HirthikBalaji/ShockGuard-CAD/Hardware/KiCad/index.html

## Redirecting to GitHub repository...

Click here if you are not redirected automatically (https://github.com/HirthikBalaji/ShockGuard-CAD/tree/main/Hardware/KiCad)
