HirthikBalaji/ShockGuard-CAD/Drawings/sheet_previews/Sheet_1.png

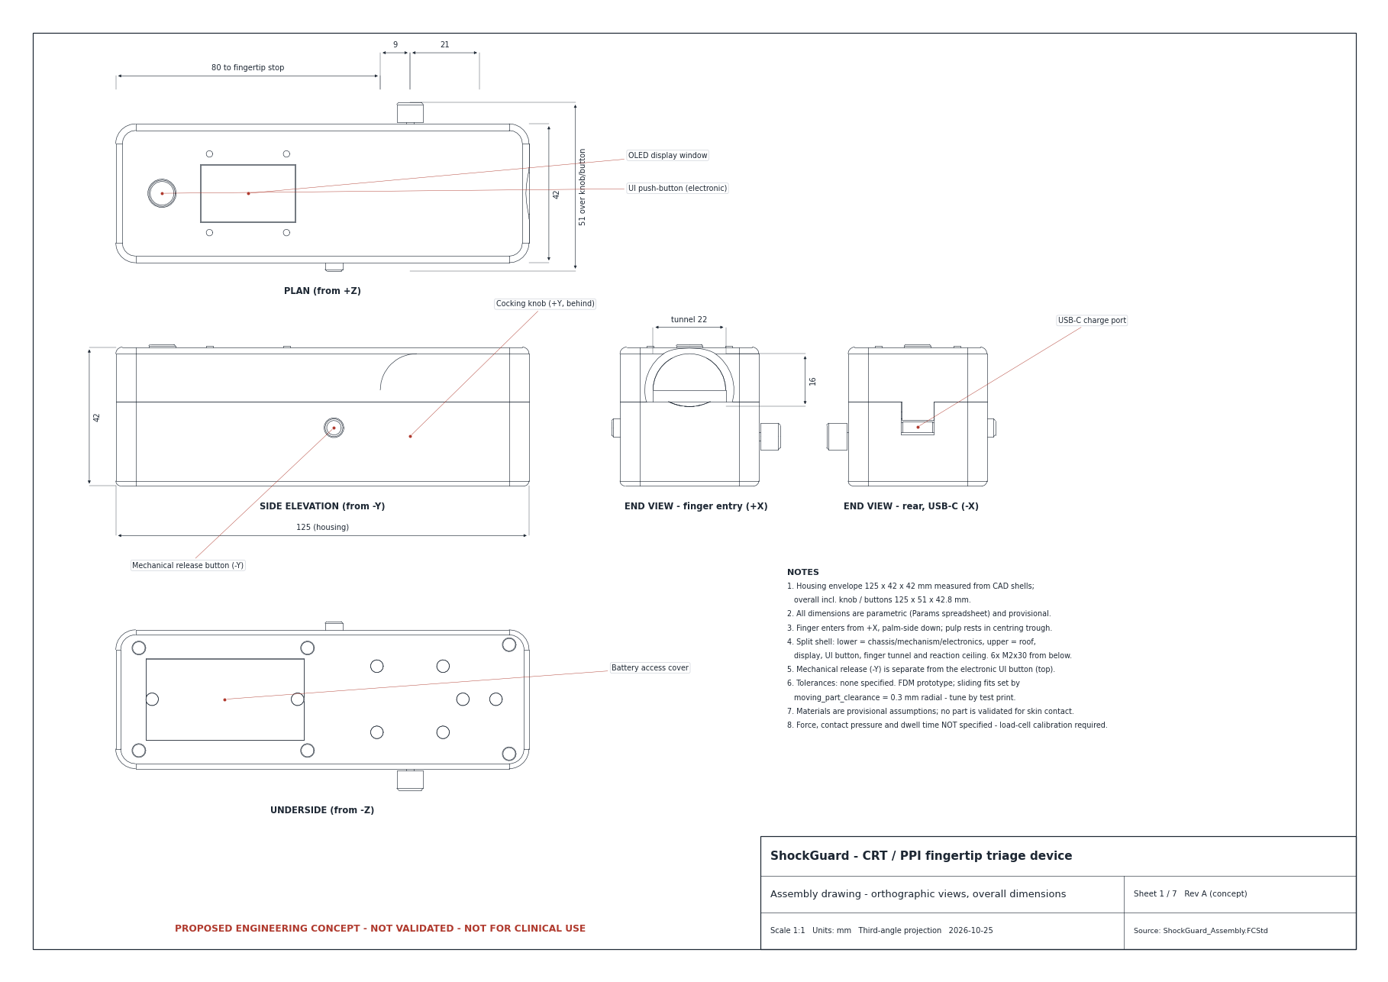
Drawings/sheet_previews/Sheet_1.png
