HirthikBalaji/ShockGuard-CAD/Drawings/sheet_previews/Sheet_2.png

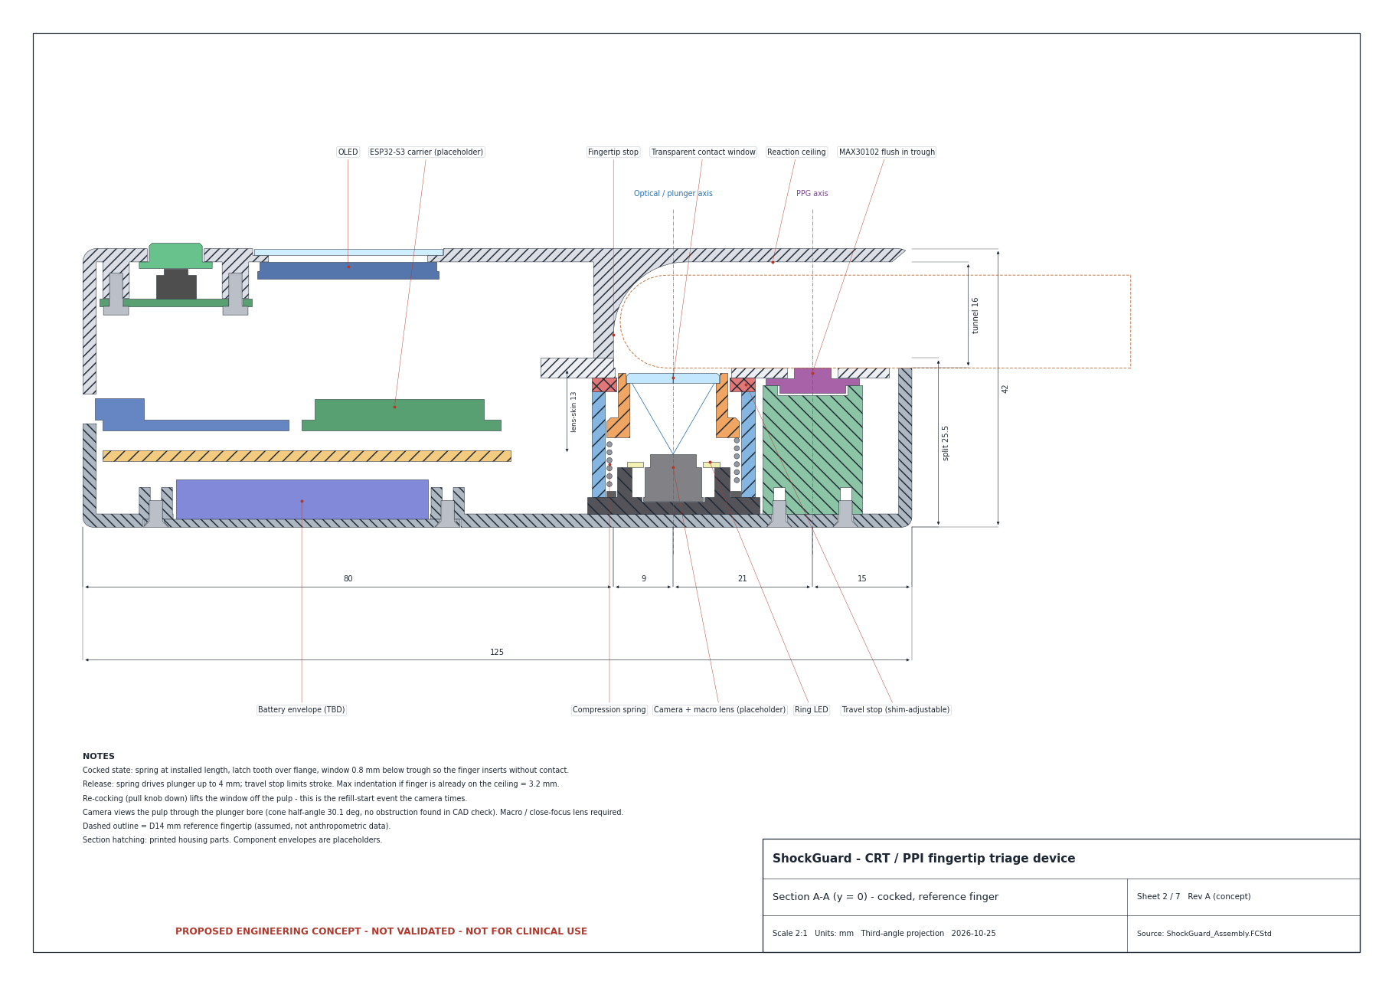
Drawings/sheet_previews/Sheet_2.png
