HirthikBalaji/ShockGuard-CAD/Drawings/sheet_previews/Sheet_3.png

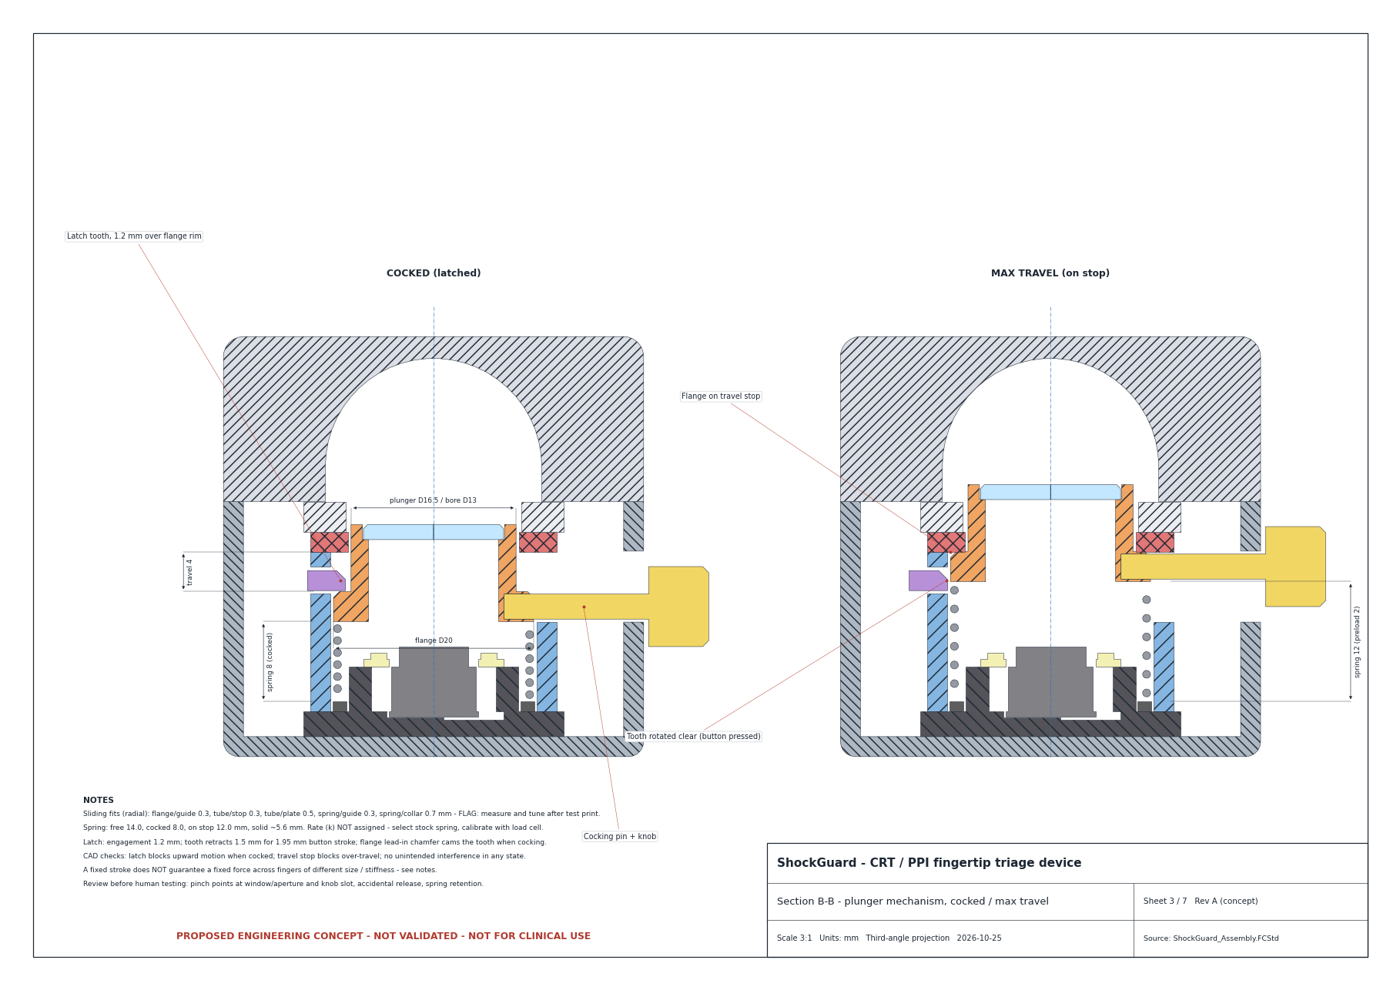
Drawings/sheet_previews/Sheet_3.png
