HirthikBalaji/ShockGuard-CAD/Drawings/sheet_previews/Sheet_4.png

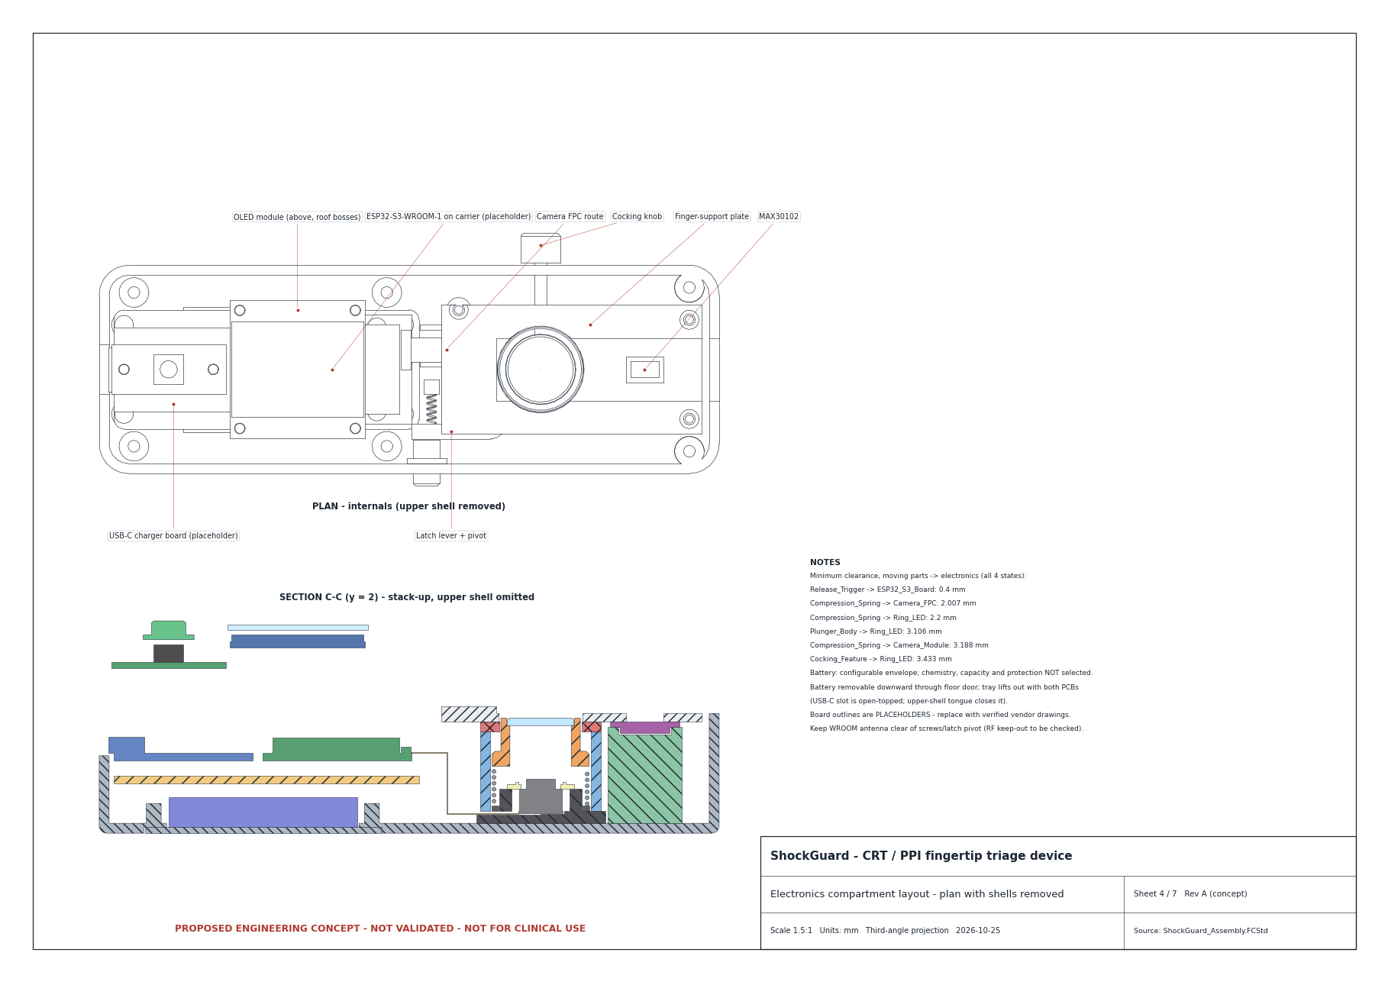
Drawings/sheet_previews/Sheet_4.png
