HirthikBalaji/ShockGuard-CAD/Drawings/sheet_previews/Sheet_5.png

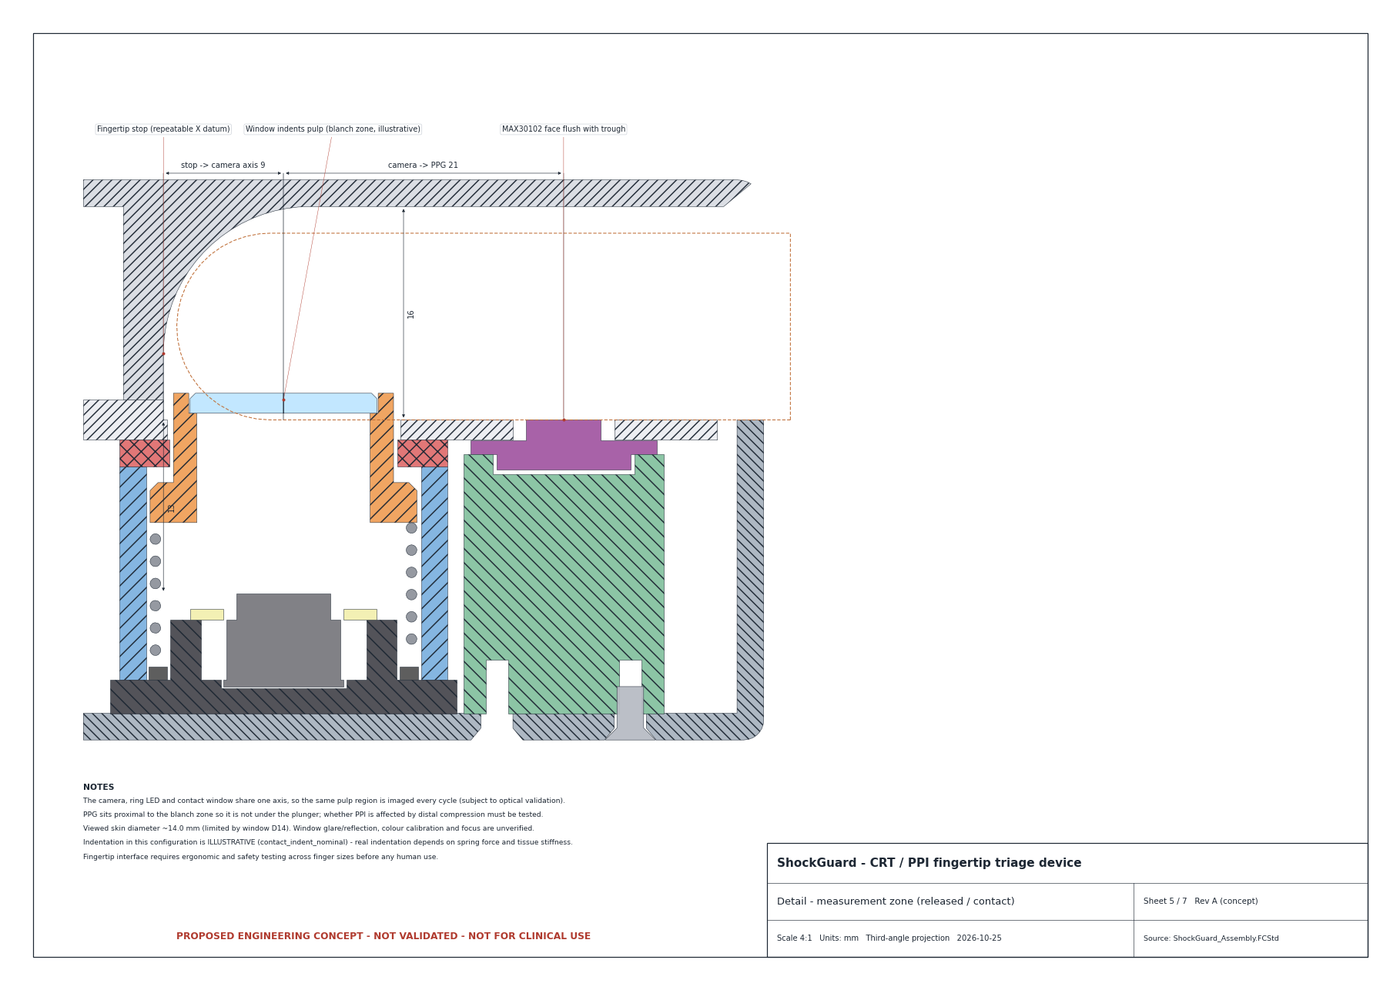
Drawings/sheet_previews/Sheet_5.png
