HirthikBalaji/ShockGuard-CAD/Drawings/sheet_previews/Sheet_6.png

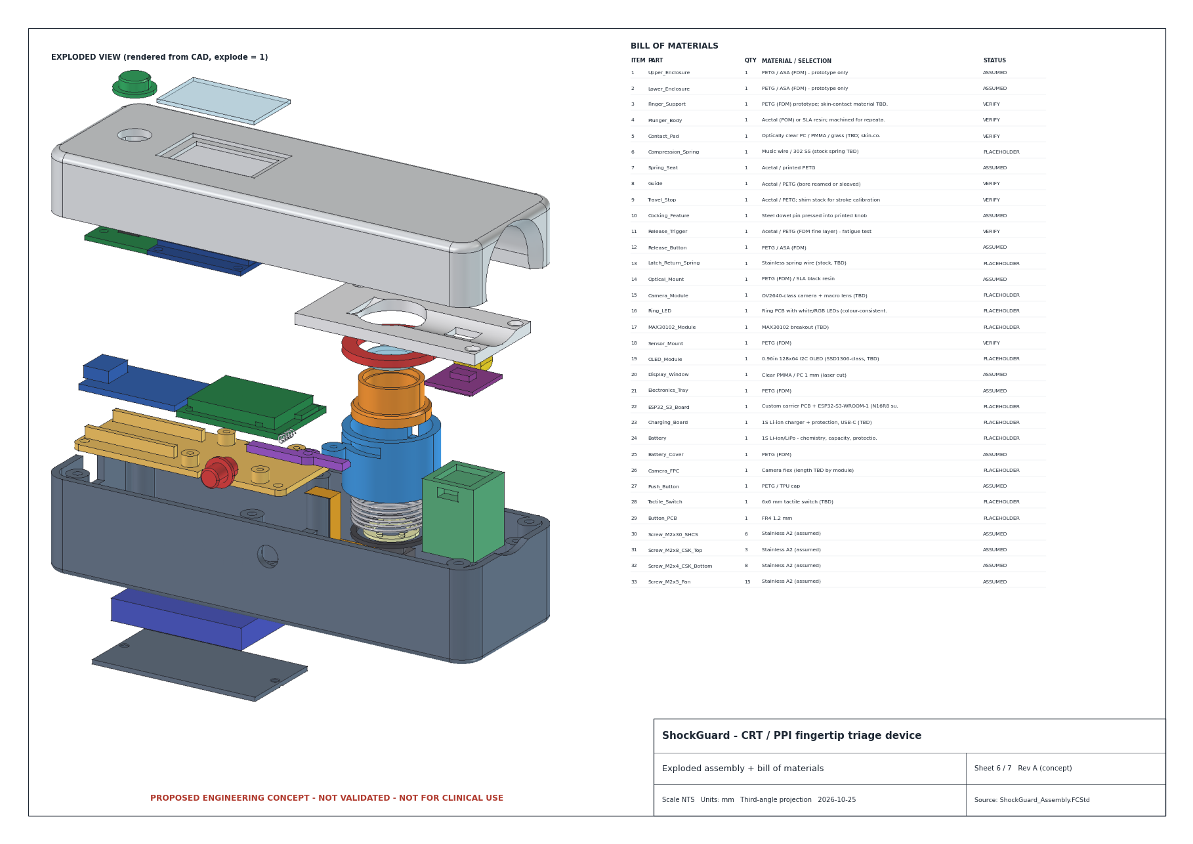
Drawings/sheet_previews/Sheet_6.png
