HirthikBalaji/ShockGuard-CAD/Drawings/sheet_previews/Sheet_7.png

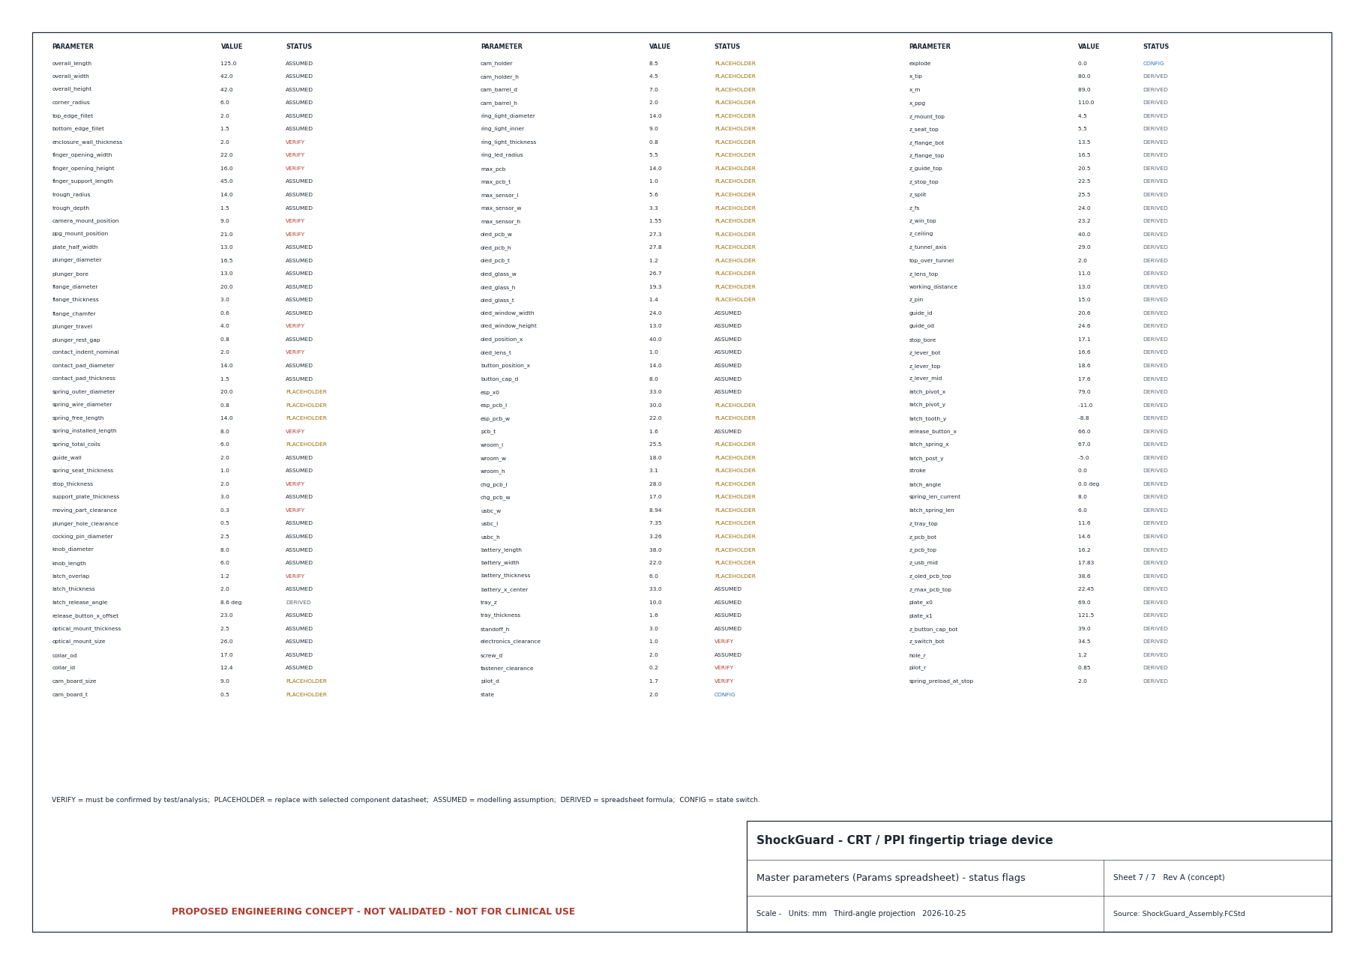
Drawings/sheet_previews/Sheet_7.png
