HirthikBalaji/ShockGuard-CAD/Renders/_raw/electronics.png

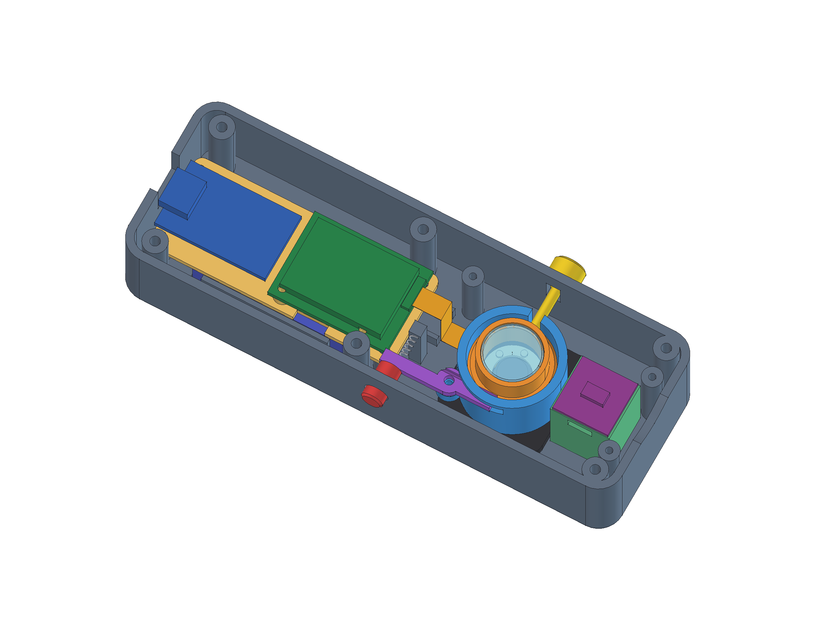
Renders/_raw/electronics.png
