HirthikBalaji/ShockGuard-CAD/Renders/_raw/electronics_display.png

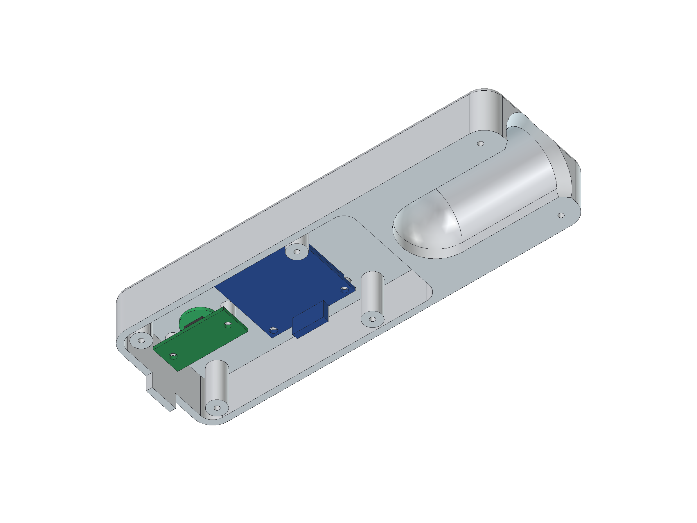
Renders/_raw/electronics_display.png
