HirthikBalaji/ShockGuard-CAD/Renders/_raw/exploded.png

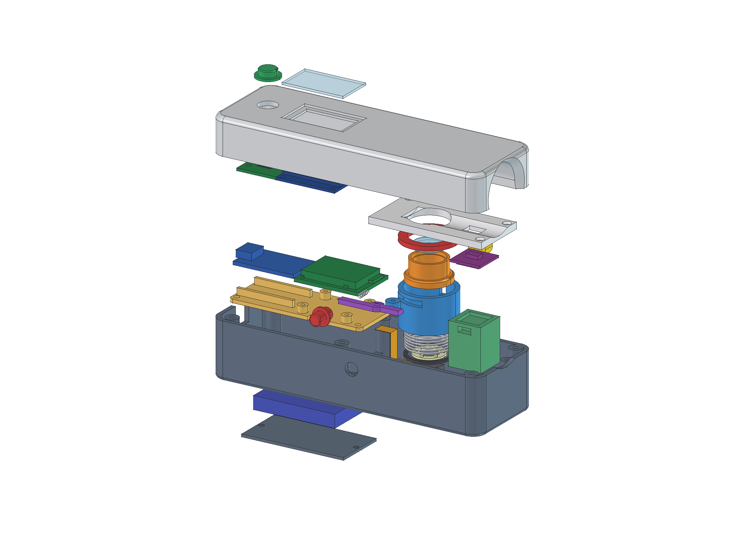
Renders/_raw/exploded.png
