HirthikBalaji/ShockGuard-CAD/Renders/_raw/iso.png

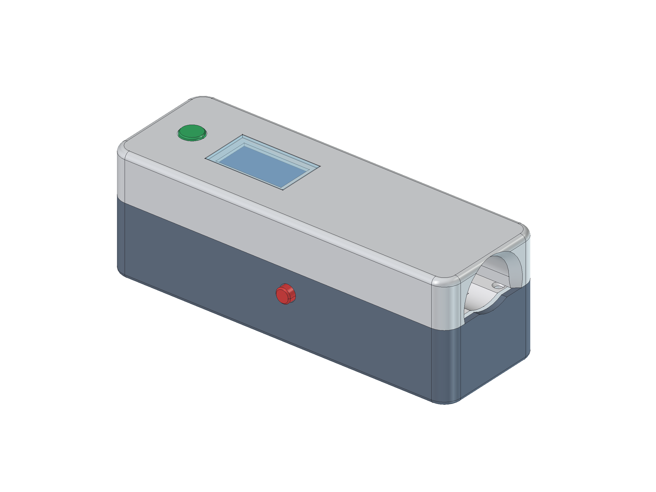
Renders/_raw/iso.png
