HirthikBalaji/ShockGuard-CAD/Renders/_raw/iso_bottom.png

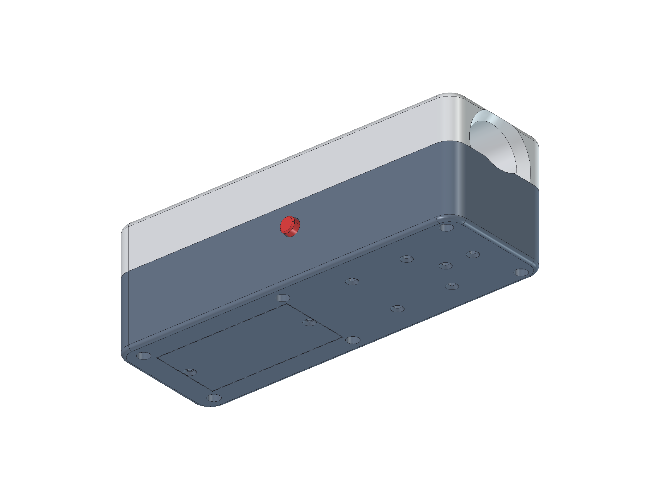
Renders/_raw/iso_bottom.png
