HirthikBalaji/ShockGuard-CAD/Renders/_raw/iso_finger.png

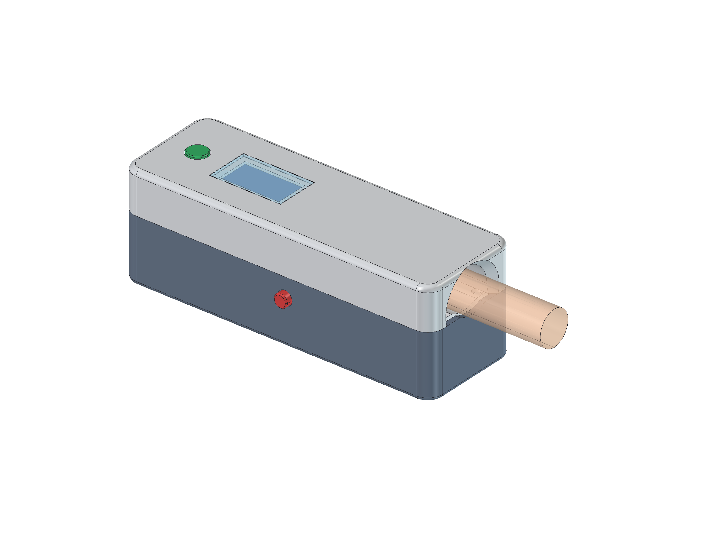
Renders/_raw/iso_finger.png
