HirthikBalaji/ShockGuard-CAD/Renders/_raw/iso_rear.png

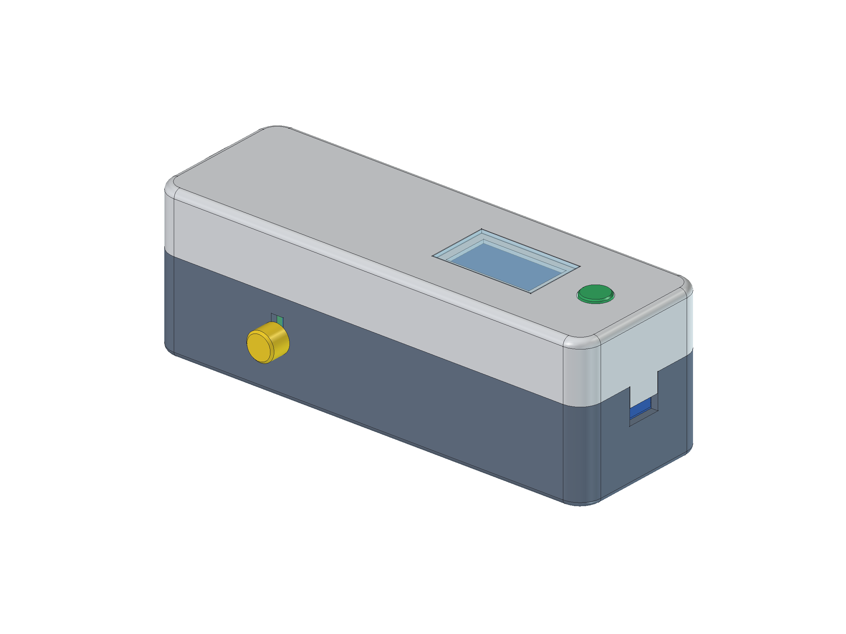
Renders/_raw/iso_rear.png
