HirthikBalaji/ShockGuard-CAD/Renders/_raw/mech_state_1.png

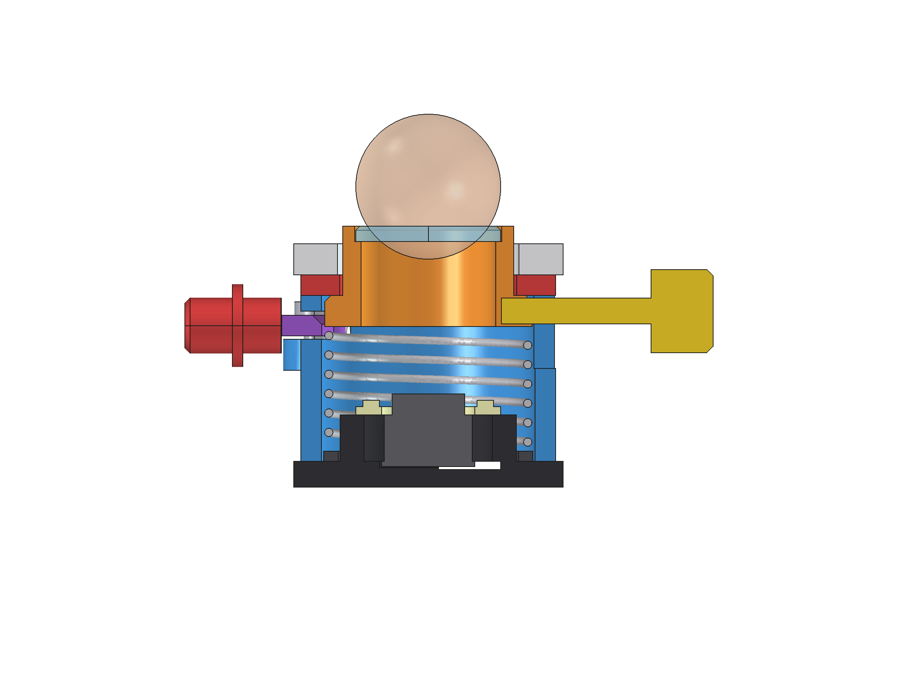
Renders/_raw/mech_state_1.png
