HirthikBalaji/ShockGuard-CAD/Renders/_raw/ortho_bottom.png

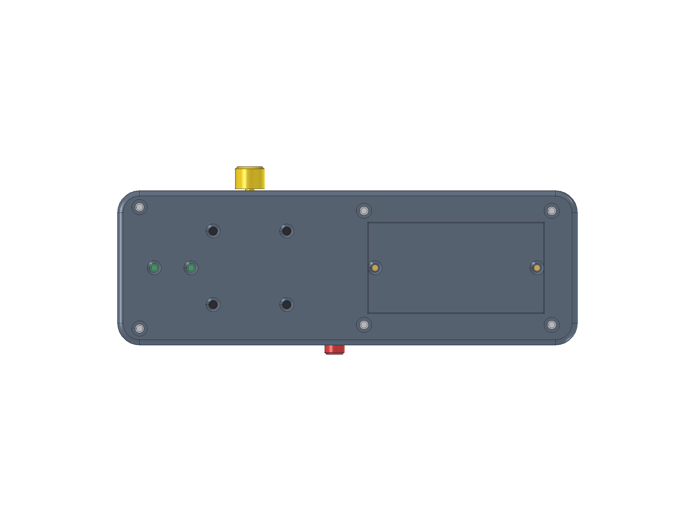
Renders/_raw/ortho_bottom.png
