HirthikBalaji/ShockGuard-CAD/Renders/_raw/ortho_front.png

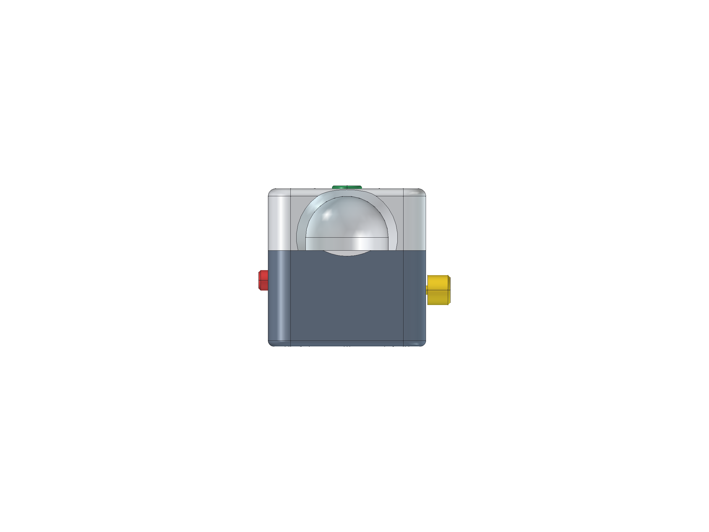
Renders/_raw/ortho_front.png
