HirthikBalaji/ShockGuard-CAD/Renders/_raw/ortho_side.png

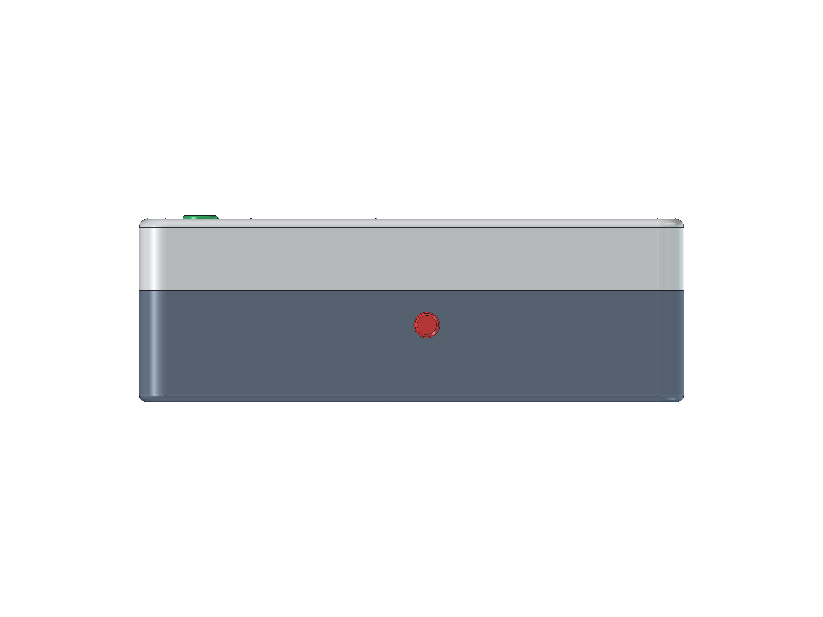
Renders/_raw/ortho_side.png
