HirthikBalaji/ShockGuard-CAD/Renders/_raw/ortho_top.png

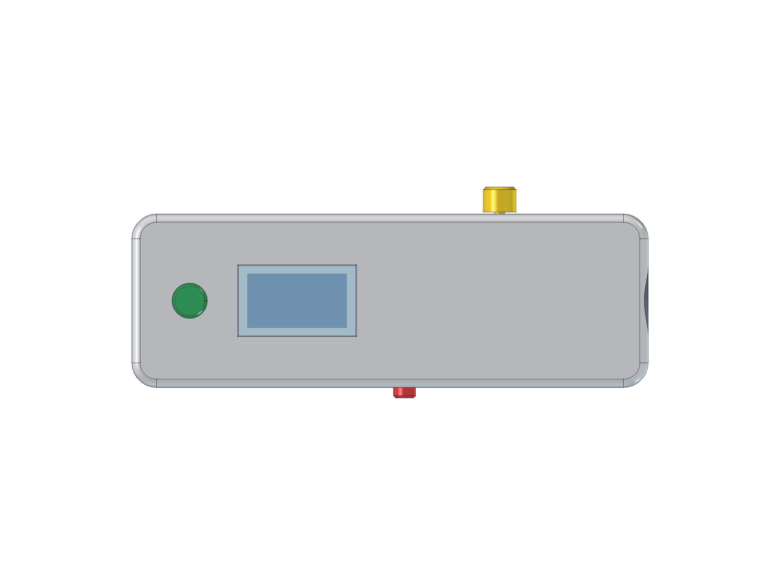
Renders/_raw/ortho_top.png
