HirthikBalaji/ShockGuard-CAD/Renders/_raw/plunger_closeup.png

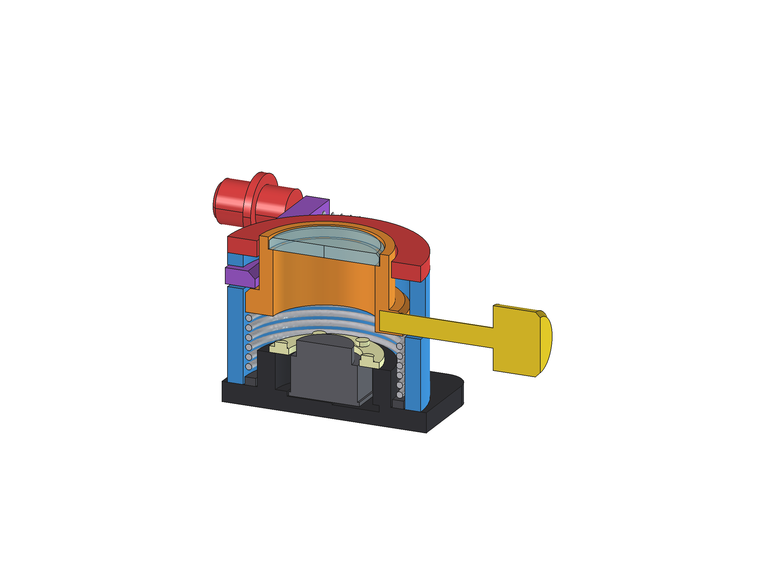
Renders/_raw/plunger_closeup.png
