HirthikBalaji/ShockGuard-CAD/Renders/_raw/section.png

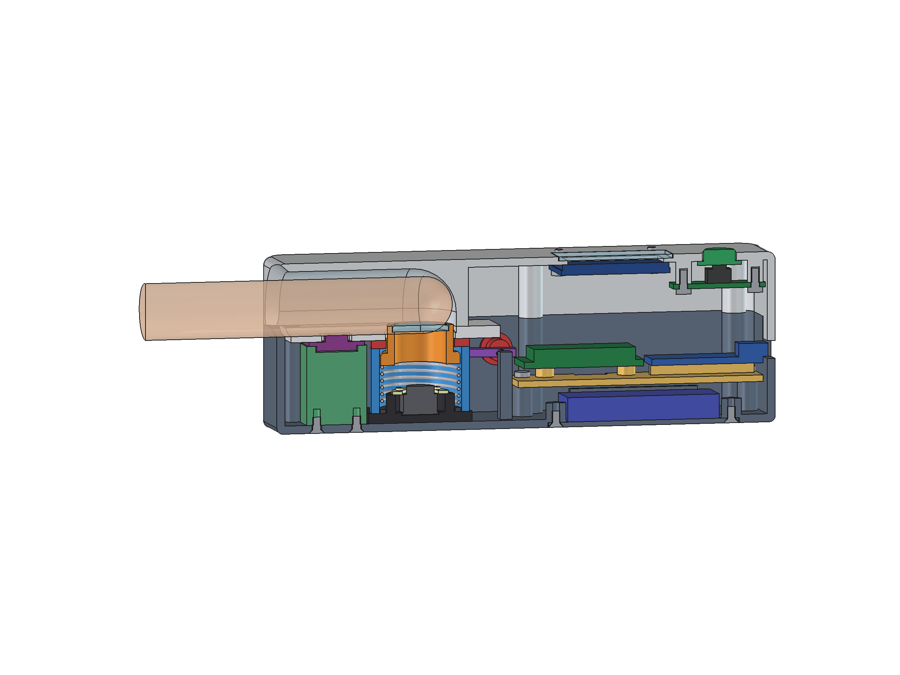
Renders/_raw/section.png
