HirthikBalaji/ShockGuard-CAD/Renders/ShockGuard_Display_and_UI_Underside.png

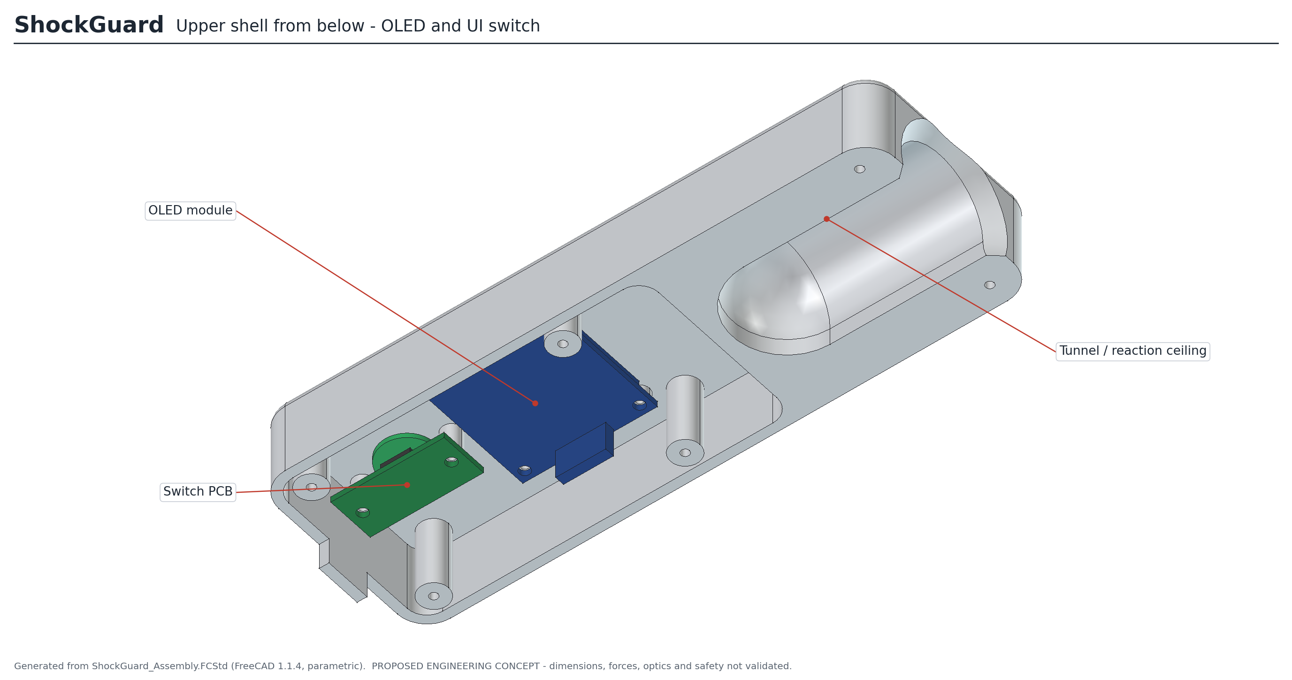
Renders/ShockGuard_Display_and_UI_Underside.png
