HirthikBalaji/ShockGuard-CAD/Renders/ShockGuard_Electronics_Compartment.png

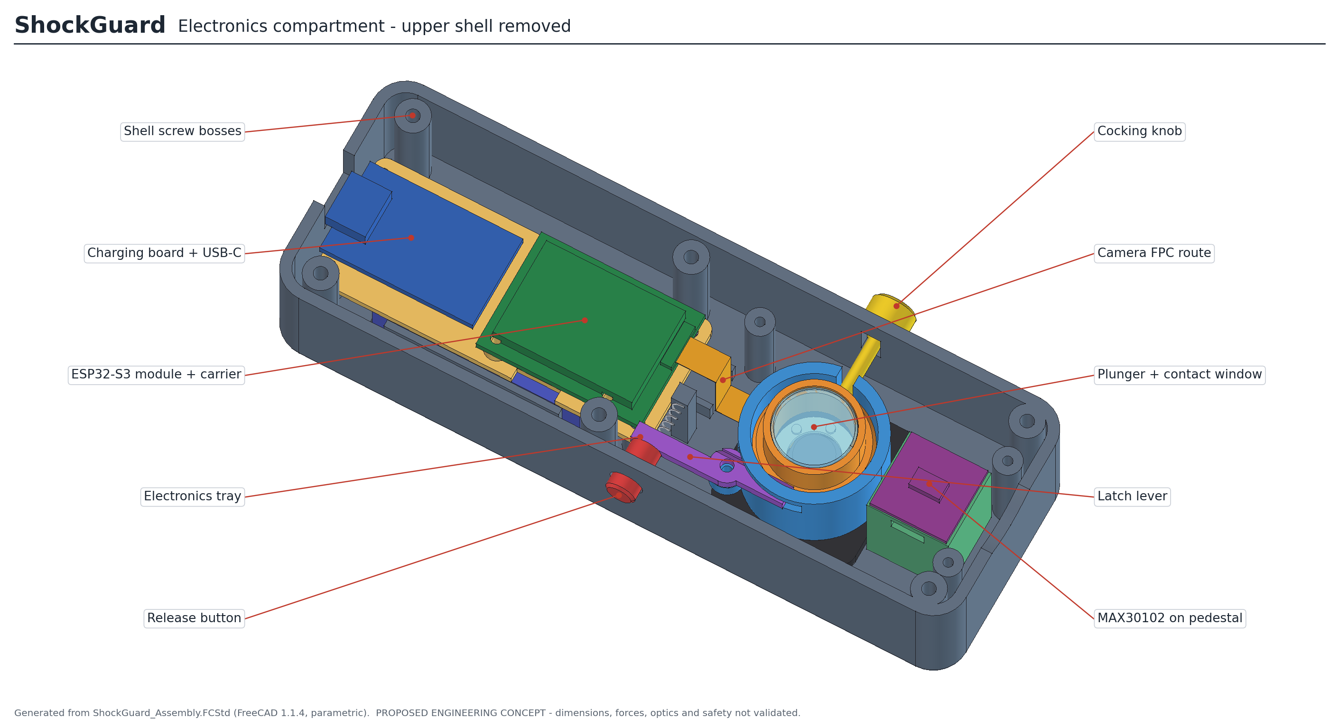
Renders/ShockGuard_Electronics_Compartment.png
