HirthikBalaji/ShockGuard-CAD/Renders/ShockGuard_Isometric_Bottom_View.png

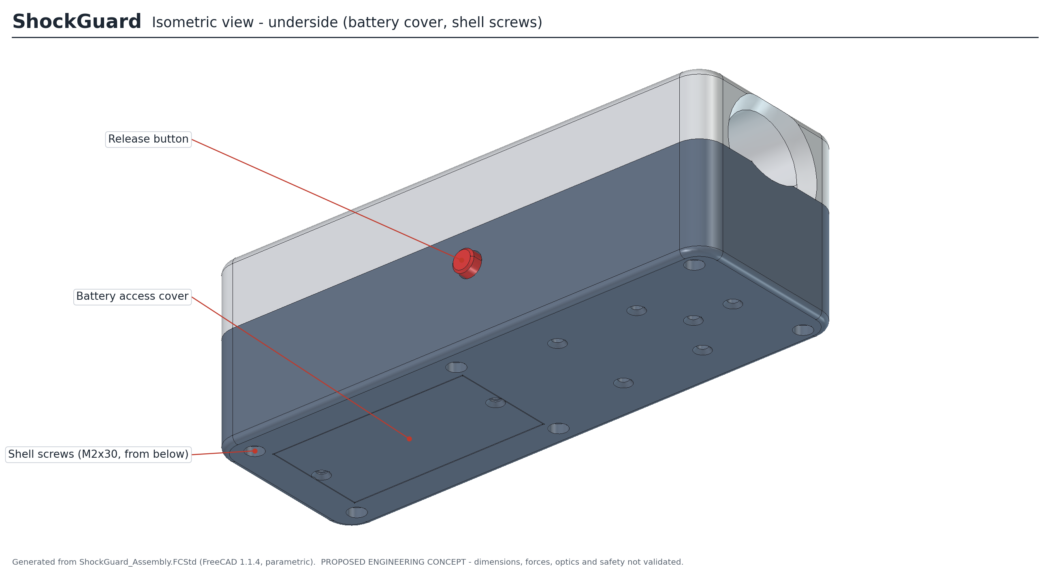
Renders/ShockGuard_Isometric_Bottom_View.png
