HirthikBalaji/ShockGuard-CAD/Renders/ShockGuard_Isometric_Rear_View.png

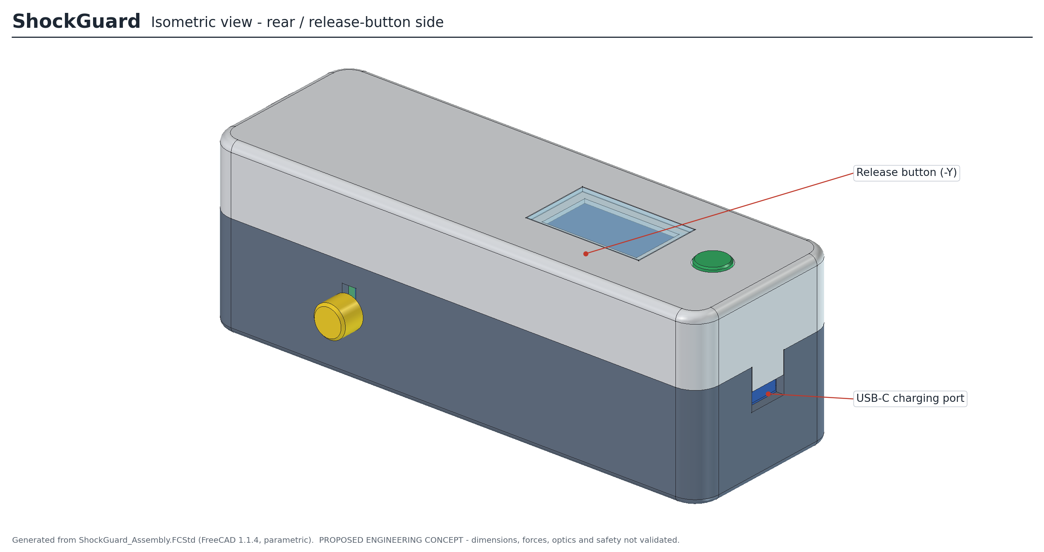
Renders/ShockGuard_Isometric_Rear_View.png
