HirthikBalaji/ShockGuard-CAD/Renders/ShockGuard_Isometric_With_Finger.png

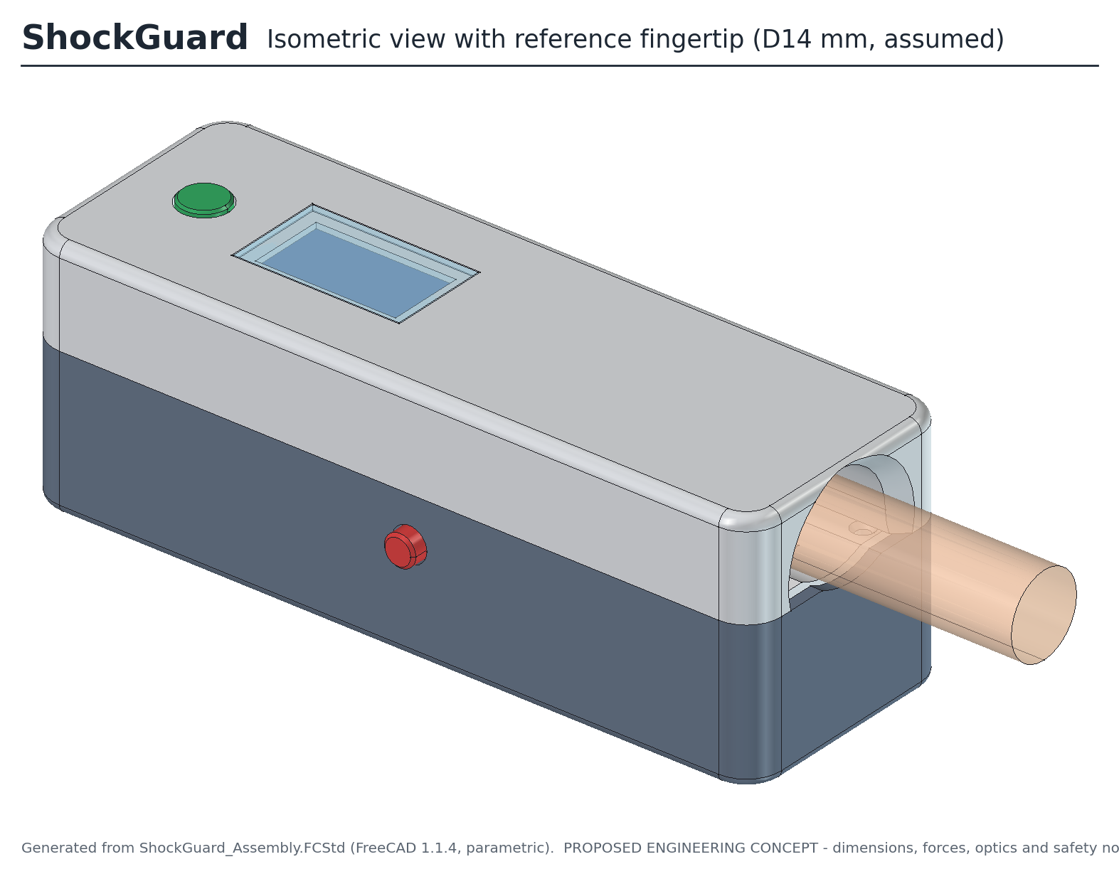
Renders/ShockGuard_Isometric_With_Finger.png
