HirthikBalaji/ShockGuard-CAD/Renders/ShockGuard_Orthographic_Views.png

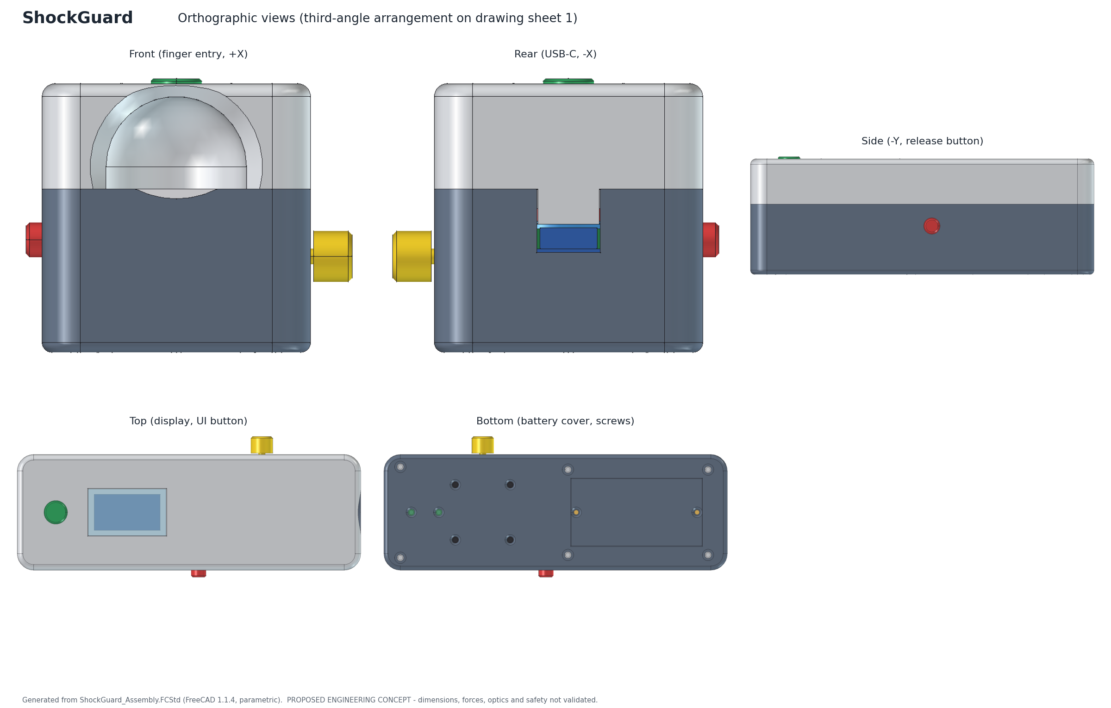
Renders/ShockGuard_Orthographic_Views.png
