HirthikBalaji/ShockGuard-CAD/STEP/ShockGuard_Assembly.step

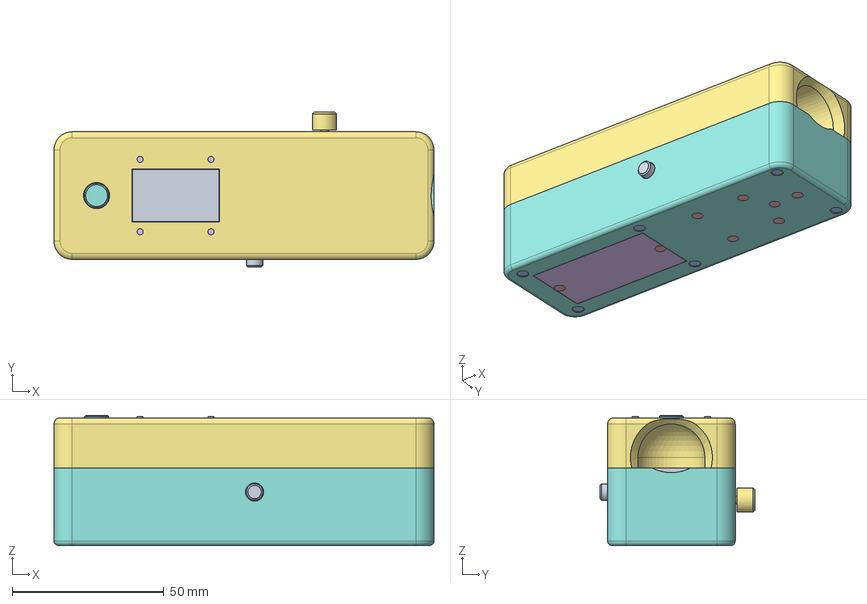
[picture p34: CAD file, 2026-10-25]
STEP/ShockGuard_Assembly.step
125.0 x 51.0 x 42.8 mm
Plunger_Body
Contact_Pad
Compression_Spring
Spring_Seat
Guide
Travel_Stop
Cocking_Feature
Release_Trigger
Release_Button
Latch_Return_Spring
Optical_Mount
Camera_Module
Ring_LED
MAX30102_Module
Sensor_Mount
OLED_Module
Display_Window
Electronics_Tray
ESP32_S3_Board
Charging_Board
Battery
Battery_Cover
Camera_FPC
Push_Button
Tactile_Switch
Button_PCB
Screw_M2x30_SHCS x 6
Screw_M2x8_CSK_Top x 3
Screw_M2x4_CSK_Bottom x 8
Screw_M2x5_Pan x 15
Upper_Enclosure
Lower_Enclosure
Finger_Support
