HirthikBalaji/ShockGuard-CAD/STL/printable/Sensor_Mount.stl

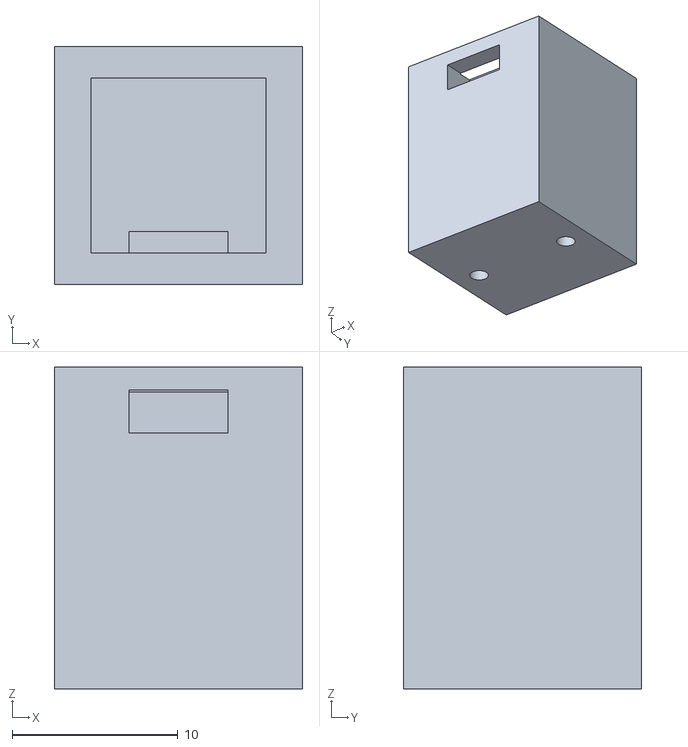
[picture p35: CAD file, 2026-10-25]
STL/printable/Sensor_Mount.stl
15.0 x 14.4 x 19.5
