HirthikBalaji/ShockGuard-CAD/STEP/components/Button_PCB.step

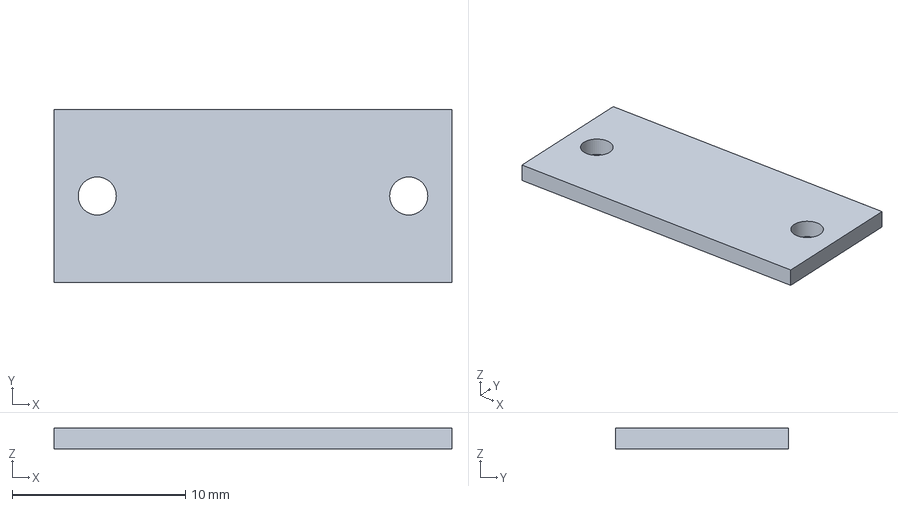
[picture p36: CAD file, 2026-10-25]
STEP/components/Button_PCB.step
23.0 x 10.0 x 1.20 mm
