HirthikBalaji/ShockGuard-CAD/STL/printable/Travel_Stop.stl

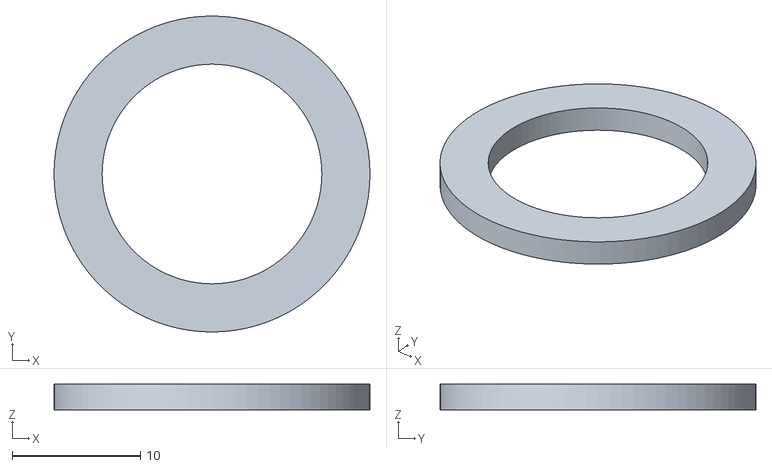
[picture p37: CAD file, 2026-10-25]
STL/printable/Travel_Stop.stl
24.6 x 24.6 x 2.00
