HirthikBalaji/ShockGuard-CAD/STEP/components/Lower_Enclosure.step

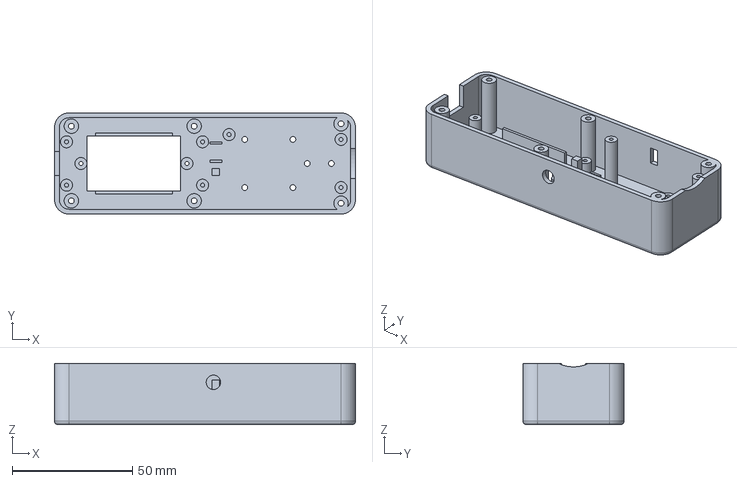
[picture p38: CAD file, 2026-10-25]
STEP/components/Lower_Enclosure.step
125.0 x 42.0 x 25.5 mm
