HirthikBalaji/ShockGuard-CAD/STL/printable/Upper_Enclosure.stl

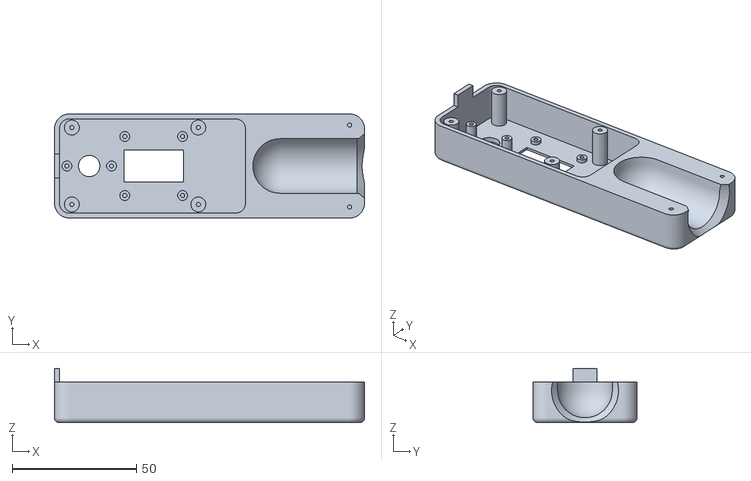
[picture p39: CAD file, 2026-10-25]
STL/printable/Upper_Enclosure.stl
125.0 x 42.0 x 21.9
