HirthikBalaji/ShockGuard-CAD/STEP/components/Battery.step

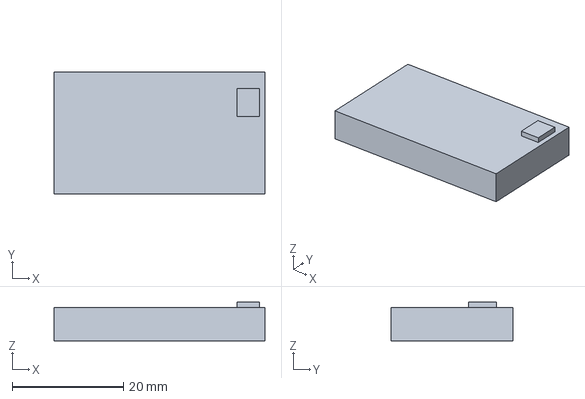
[picture p40: CAD file, 2026-10-25]
STEP/components/Battery.step
38.0 x 22.0 x 7.00 mm
