HirthikBalaji/ShockGuard-CAD/STL/printable/Push_Button.stl

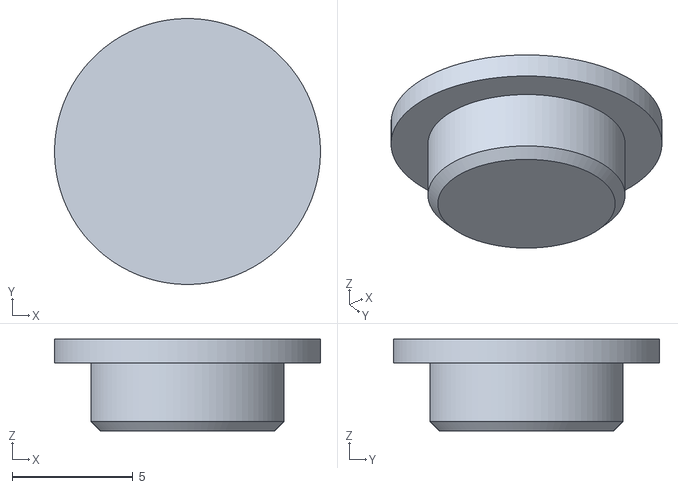
[picture p41: CAD file, 2026-10-25]
STL/printable/Push_Button.stl
11.0 x 11.0 x 3.80
