HirthikBalaji/ShockGuard-CAD/STL/printable/Release_Trigger.stl

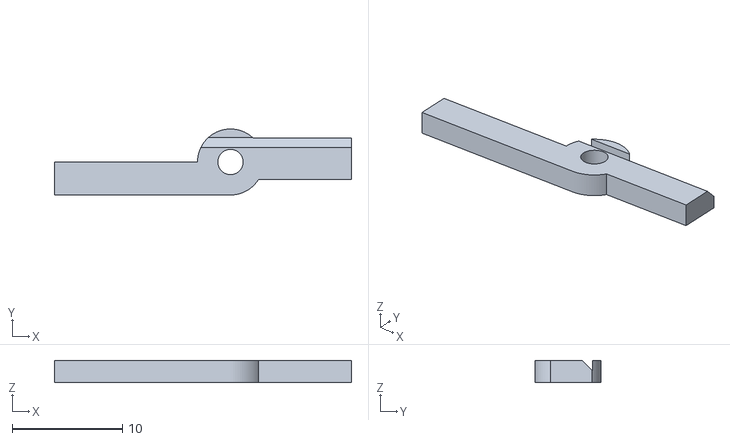
[picture p42: CAD file, 2026-10-25]
STL/printable/Release_Trigger.stl
27.0 x 6.00 x 2.00
