HirthikBalaji/ShockGuard-CAD/STEP/components/Camera_Module.step

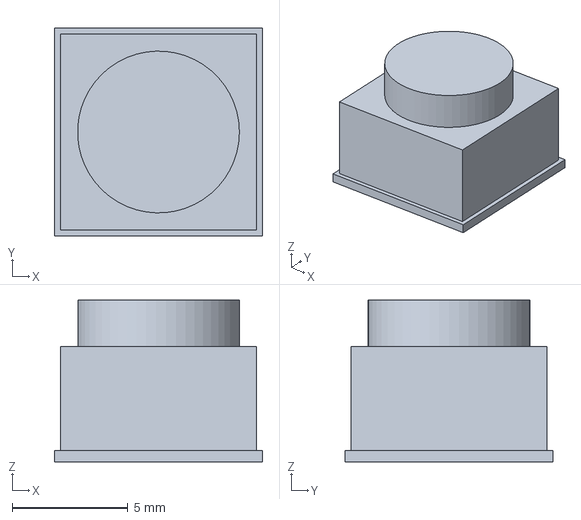
[picture p43: CAD file, 2026-10-25]
STEP/components/Camera_Module.step
9.00 x 9.00 x 7.00 mm
