HirthikBalaji/ShockGuard-CAD/STL/printable/Lower_Enclosure.stl

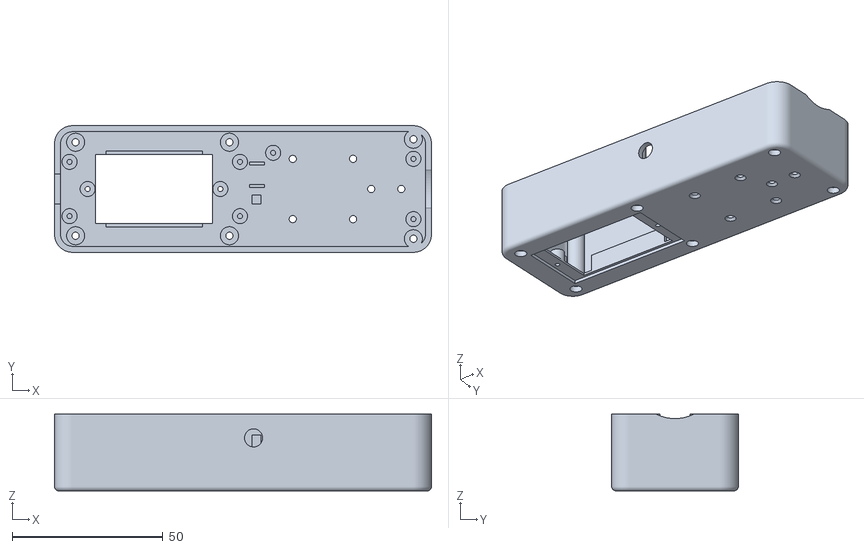
[picture p44: CAD file, 2026-10-25]
STL/printable/Lower_Enclosure.stl
125.0 x 42.0 x 25.5
