HirthikBalaji/ShockGuard-CAD/STEP/components/Compression_Spring.step

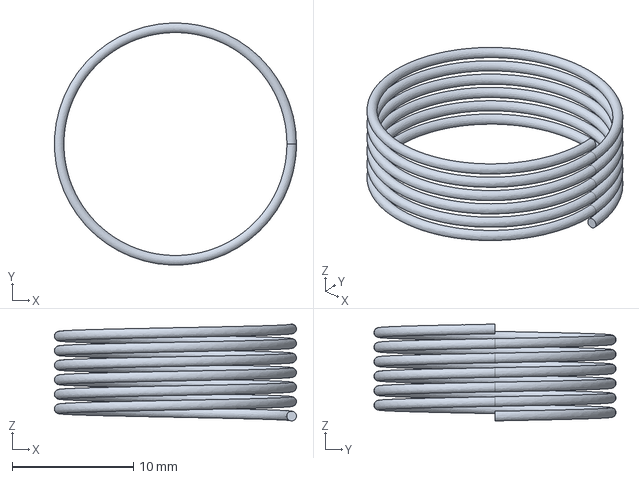
[picture p45: CAD file, 2026-10-25]
STEP/components/Compression_Spring.step
20.0 x 20.0 x 8.00 mm
