HirthikBalaji/ShockGuard-CAD/STL/printable/Plunger_Body.stl

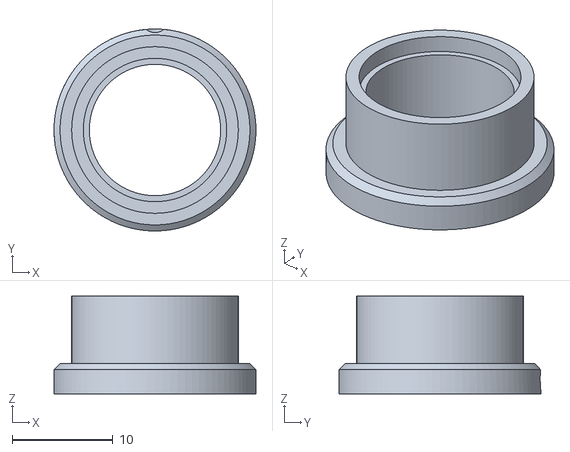
[picture p46: CAD file, 2026-10-25]
STL/printable/Plunger_Body.stl
20.0 x 20.0 x 9.70
