HirthikBalaji/ShockGuard-CAD/STEP/components/Ring_LED.step

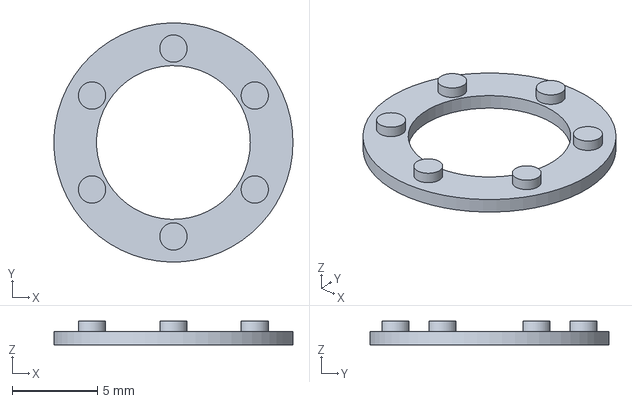
[picture p47: CAD file, 2026-10-25]
STEP/components/Ring_LED.step
14.0 x 14.0 x 1.40 mm
