HirthikBalaji/ShockGuard-CAD/STL/printable/Optical_Mount.stl

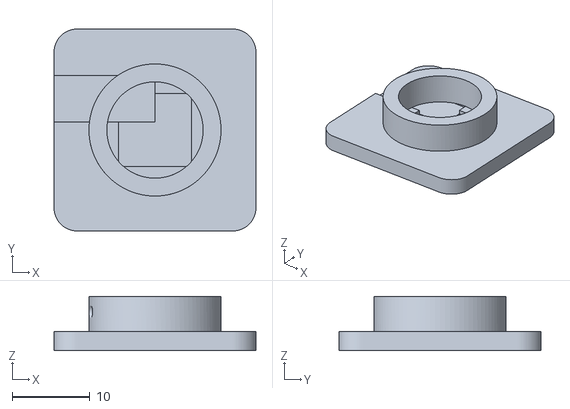
[picture p48: CAD file, 2026-10-25]
STL/printable/Optical_Mount.stl
26.0 x 26.0 x 7.00
