HirthikBalaji/ShockGuard-CAD/STL/printable/Battery_Cover.stl

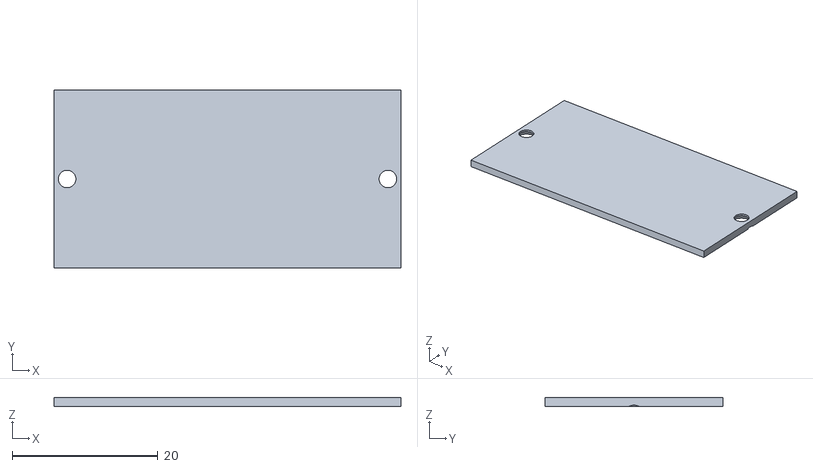
[picture p49: CAD file, 2026-10-25]
STL/printable/Battery_Cover.stl
47.6 x 24.4 x 1.20
