HirthikBalaji/ShockGuard-CAD/STEP/components/Tactile_Switch.step

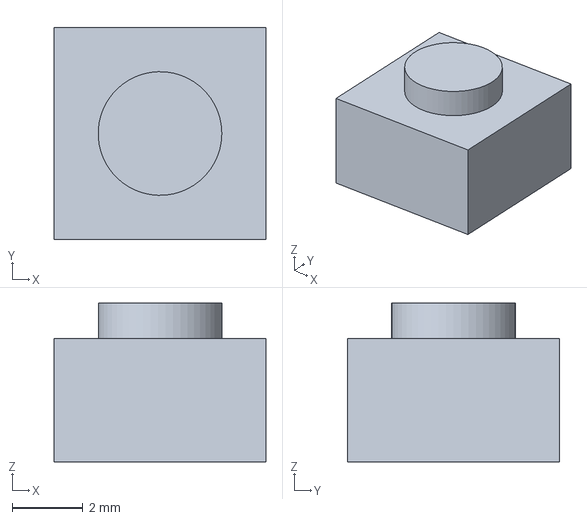
[picture p50: CAD file, 2026-10-25]
STEP/components/Tactile_Switch.step
6.00 x 6.00 x 4.50 mm
