HirthikBalaji/ShockGuard-CAD/STL/printable/Spring_Seat.stl

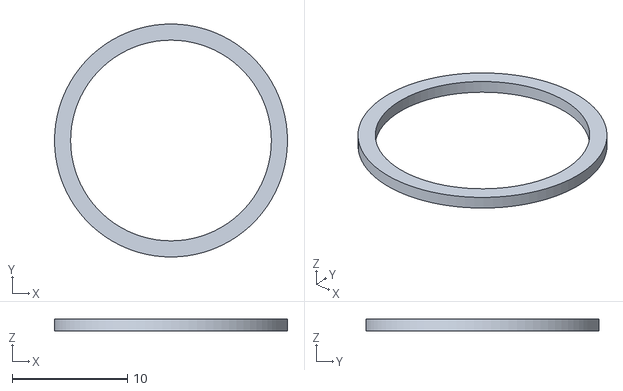
[picture p51: CAD file, 2026-10-25]
STL/printable/Spring_Seat.stl
20.2 x 20.2 x 1.00
