HirthikBalaji/ShockGuard-CAD/STEP/components/Camera_FPC.step

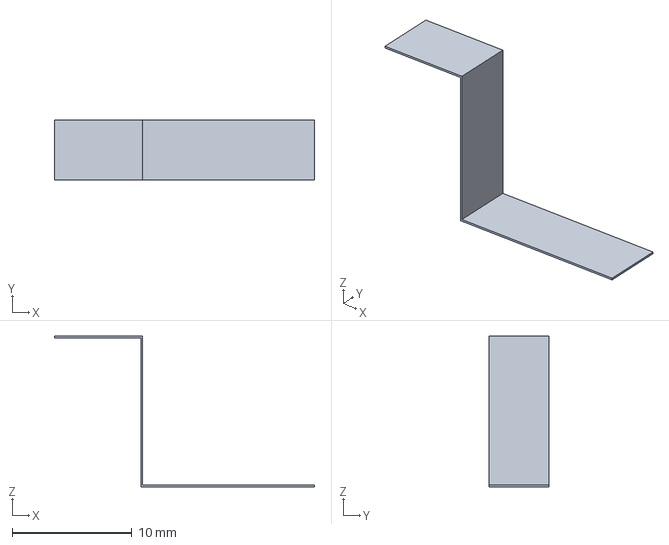
[picture p52: CAD file, 2026-10-25]
STEP/components/Camera_FPC.step
21.7 x 5.00 x 12.6 mm
