HirthikBalaji/ShockGuard-CAD/STL/printable/Electronics_Tray.stl

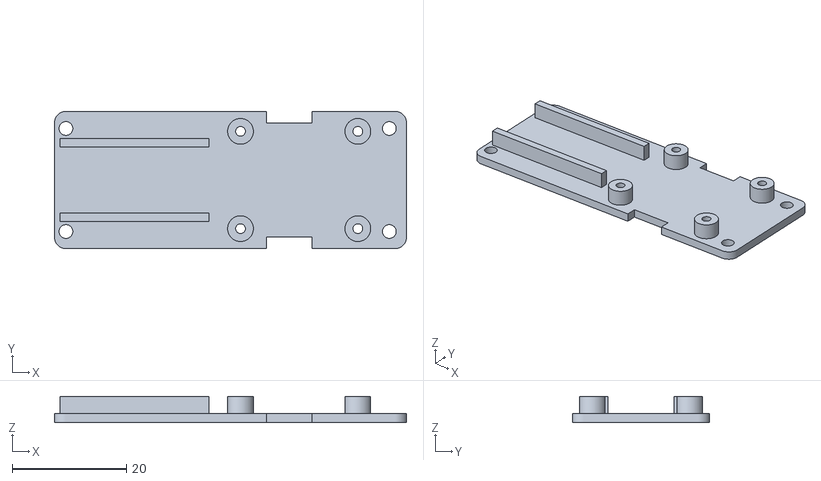
[picture p53: CAD file, 2026-10-25]
STL/printable/Electronics_Tray.stl
61.5 x 24.0 x 4.60
