HirthikBalaji/ShockGuard-CAD/STEP/components/Finger_Support.step

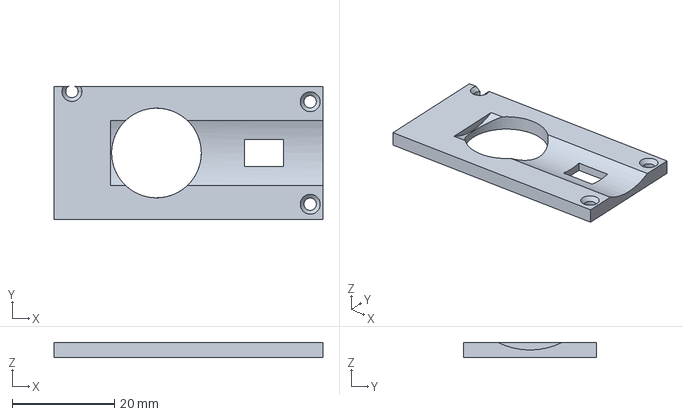
[picture p54: CAD file, 2026-10-25]
STEP/components/Finger_Support.step
52.5 x 26.0 x 3.00 mm
