HirthikBalaji/ShockGuard-CAD/STL/printable/Finger_Support.stl

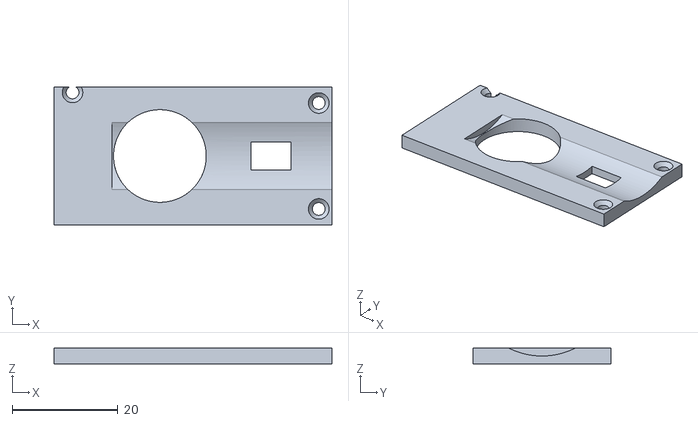
[picture p55: CAD file, 2026-10-25]
STL/printable/Finger_Support.stl
52.5 x 26.0 x 3.00
