HirthikBalaji/ShockGuard-CAD/STL/printable/Cocking_Feature.stl

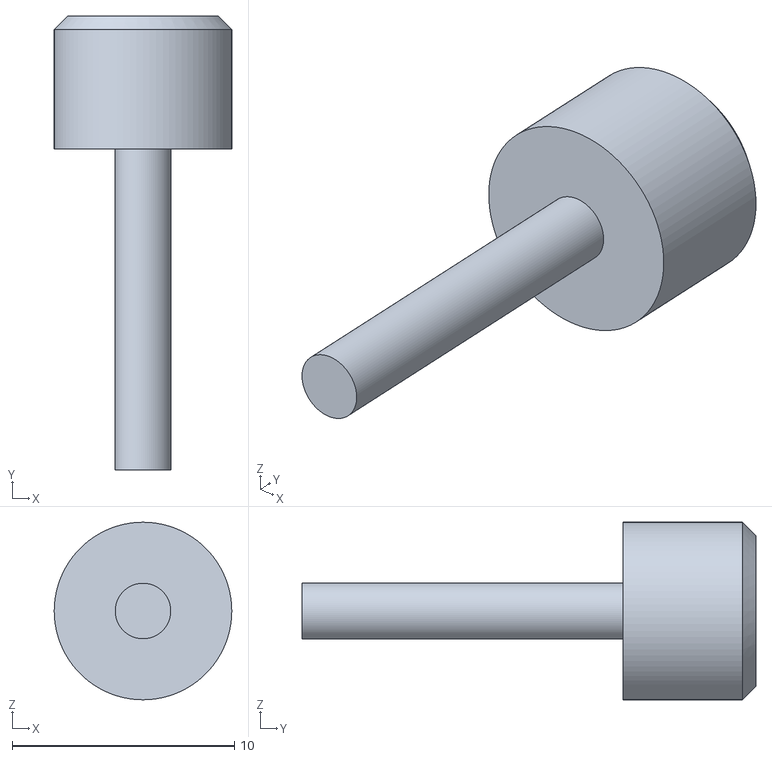
[picture p56: CAD file, 2026-10-25]
STL/printable/Cocking_Feature.stl
8.00 x 20.5 x 8.00
