HirthikBalaji/ShockGuard-CAD/STEP/components/ESP32_S3_Board.step

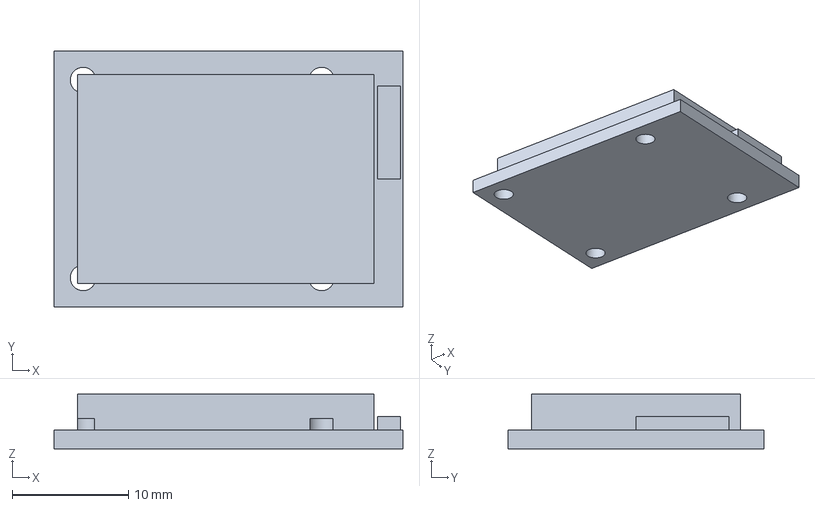
[picture p57: CAD file, 2026-10-25]
STEP/components/ESP32_S3_Board.step
30.0 x 22.0 x 4.70 mm
