HirthikBalaji/ShockGuard-CAD/STL/printable/Release_Button.stl

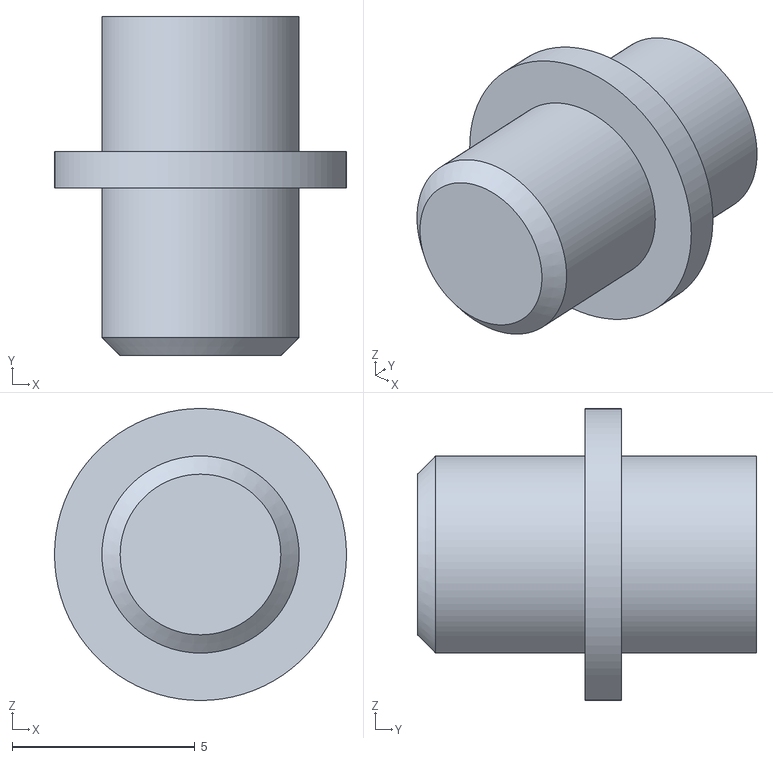
[picture p58: CAD file, 2026-10-25]
STL/printable/Release_Button.stl
8.00 x 9.30 x 8.00
