HirthikBalaji/ShockGuard-CAD/STEP/components/Upper_Enclosure.step

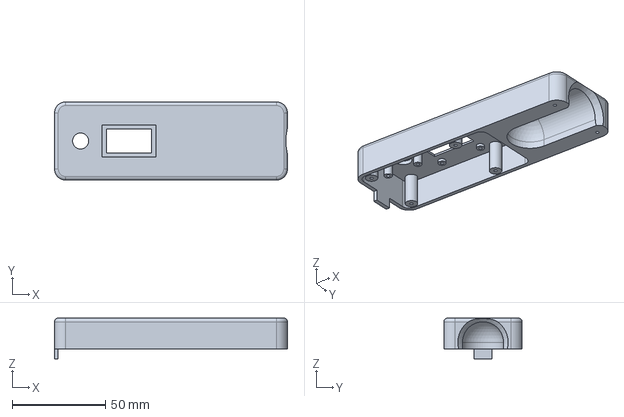
[picture p59: CAD file, 2026-10-25]
STEP/components/Upper_Enclosure.step
125.0 x 42.0 x 21.9 mm
