HirthikBalaji/ShockGuard-CAD/STL/printable/Guide.stl

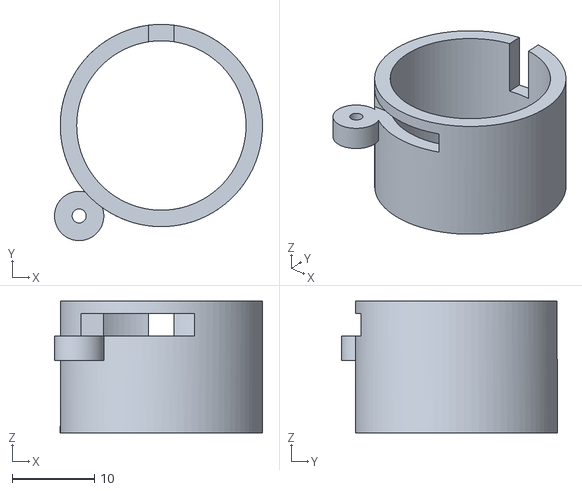
[picture p60: CAD file, 2026-10-25]
STL/printable/Guide.stl
25.3 x 26.3 x 16.0
