HirthikBalaji/ShockGuard-CAD/STEP/components/Contact_Pad.step

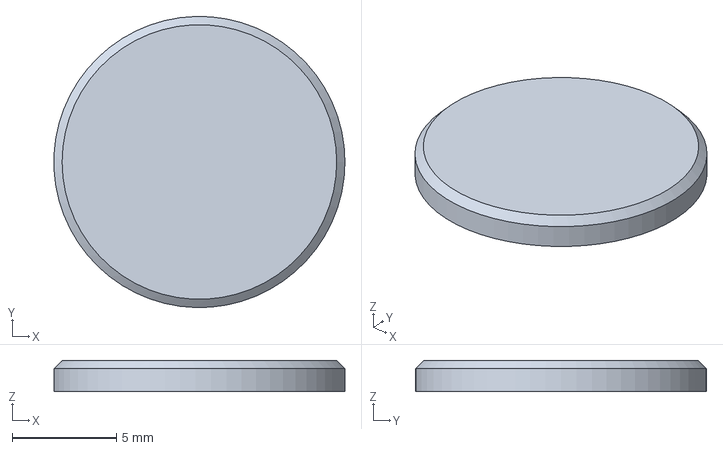
[picture p61: CAD file, 2026-10-25]
STEP/components/Contact_Pad.step
14.0 x 14.0 x 1.50 mm
