HirthikBalaji/ShockGuard-CAD/STEP/components/Charging_Board.step

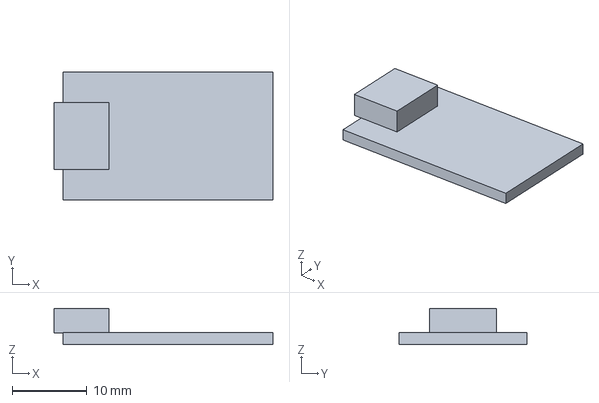
[picture p62: CAD file, 2026-10-25]
STEP/components/Charging_Board.step
29.2 x 17.0 x 4.86 mm
