HirthikBalaji/ShockGuard-CAD/STEP/components/Display_Window.step

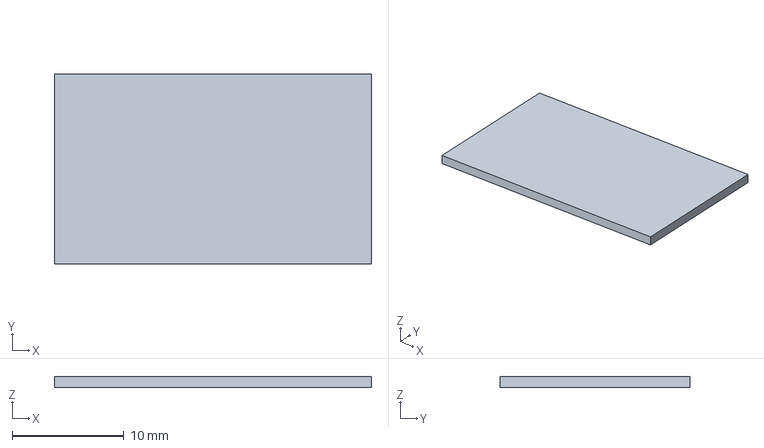
[picture p63: CAD file, 2026-10-25]
STEP/components/Display_Window.step
28.4 x 17.0 x 1.00 mm
