HirthikBalaji/ShockGuard-CAD/STEP/components/Latch_Return_Spring.step

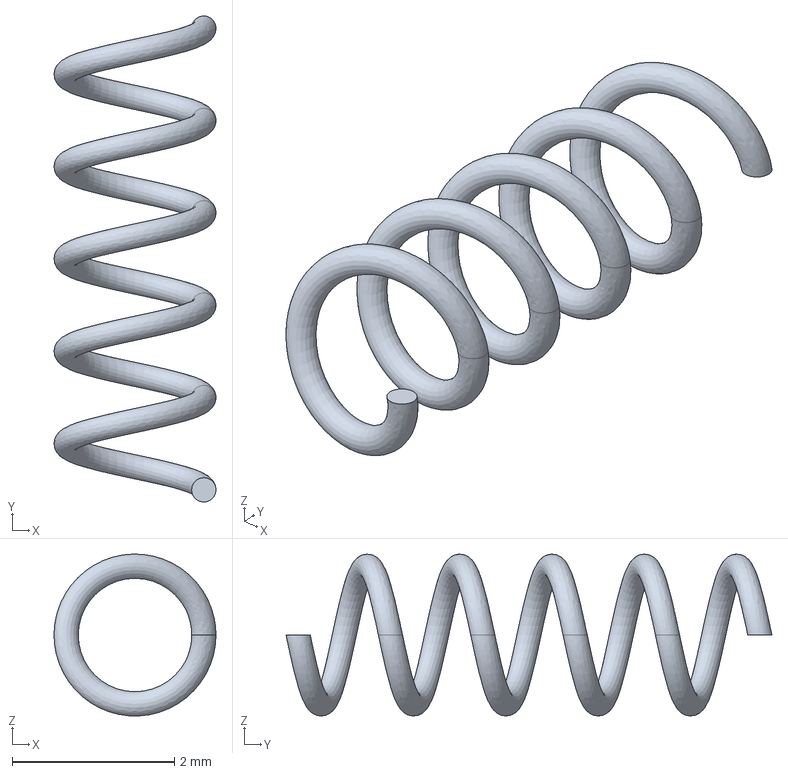
[picture p64: CAD file, 2026-10-25]
STEP/components/Latch_Return_Spring.step
2.00 x 6.00 x 2.00 mm
