HirthikBalaji/ShockGuard-CAD/STEP/components/OLED_Module.step

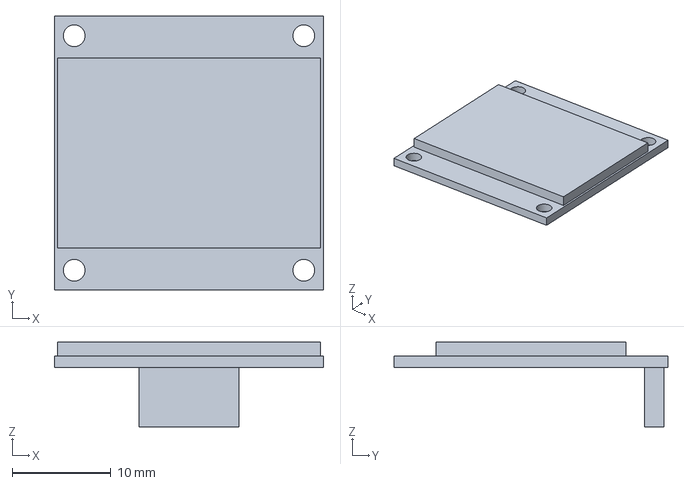
[picture p65: CAD file, 2026-10-25]
STEP/components/OLED_Module.step
27.3 x 27.8 x 8.60 mm
