HirthikBalaji/ShockGuard-CAD/(list of files, cad)

Other CAD files:
STEP/components/Plunger_Body.step
STEP/components/Optical_Mount.step
STEP/components/Battery_Cover.step
STEP/components/Electronics_Tray.step
STEP/components/Sensor_Mount.step
STEP/components/Push_Button.step
STEP/components/Release_Button.step
STEP/components/Travel_Stop.step
STEP/components/Release_Trigger.step
STEP/components/Cocking_Feature.step
STEP/components/Spring_Seat.step
STEP/components/Guide.step
CAD/ShockGuard_Assembly.FCStd
STEP/components/MAX30102_Module.step
STEP/components/Screw_M2x30_SHCS.step
STEP/components/Screw_M2x4_CSK_Bottom.step
STEP/components/Screw_M2x5_Pan.step
STEP/components/Screw_M2x8_CSK_Top.step
STL/ShockGuard_Assembly.stl
