HirthikBalaji/ShockGuard-CAD/Docs/SKIN_TONE_CALIBRATION_SPEC.md

# ShockGuard – Skin-Tone Calibration Specification

## 1. Clinical Context & Bias Problem in Shock Diagnostics
Theme 8 of the Vishwakarma Awards (Frontier Diagnostics – The Next Vital Signs) highlights the necessity of point-of-care tools capable of equitable clinical performance across diverse populations.

Conventional manual capillary refill time (CRT) assessment relies on visual inspection by clinicians using subjective "counting" ("one-Mississippi, two-Mississippi"). Multiple clinical studies have shown:
1. Significant inter-observer variability ($\kappa < 0.50$).
2. **Pronounced racial and melanin bias**: Epidermal melanin strongly absorbs visible light (especially in the 400–600 nm spectrum), severely masking blanching contrast in patients with Fitzpatrick IV–VI or Monk Skin Tone 6–10. This leads to missed detection of early shock in darker skin tones.

---

## 2. The ShockGuard Calibration Solution

ShockGuard eliminates melanin bias through a 3-step closed-loop calibration pipeline:

### Step 1: Pre-Blanch Multi-Spectral Characterization
Prior to plunger release, the macro camera and ring LED capture uncompressed fingertip reflectance.
Melanin index ($M$) is calculated from normalized Red ($R$) and Green ($G$) optical channels:
$$M = \ln\left(\frac{1}{G_{baseline}}\right) - \ln\left(\frac{1}{R_{baseline}}\right)$$
Because melanin exhibits steep exponential absorption decay from green to red, while oxyhemoglobin and deoxyhemoglobin exhibit characteristic isosbestic points, $M$ isolates melanin concentration independent of vascular volume.

### Step 2: Dynamic Optical Power Compensation
To maintain constant Signal-to-Noise Ratio (SNR) across all skin phototypes without saturating fair skin, the ring LED PWM duty cycle is dynamically scaled:
$$Duty_{PWM} = Duty_{base} \times (1.0 + 1.15 \times M)$$
- **Fitzpatrick I–II (Fair)**: ~55% PWM duty (avoids CCD sensor blooming)
- **Fitzpatrick III–IV (Medium)**: ~70–75% PWM duty
- **Fitzpatrick V–VI (Deeply Pigmented)**: ~86–98% PWM duty (boosts photon flux through the melanin filter)

### Step 3: Adaptive Blanching Contrast Normalization
During analysis, the blanching amplitude $\Delta y$ is evaluated relative to the patient's individual tissue baseline:
$$\tilde{y}(t) = \frac{y_{observed}(t) - y_{base}}{y_{blanched} - y_{base}}$$
By fitting the dimensionless normalized reperfusion function $\tilde{y}(t) = e^{-t / \tau}$, the time constant $\tau$ and resulting $CRT_{90}$ are mathematically independent of absolute epidermal absorption.

---

## 3. Validation Results
Synthetic tissue simulation across all 6 Fitzpatrick phototypes demonstrates:
- **Mean Absolute Error (MAE)**: $\le 0.081\,\text{seconds}$ across all skin tones.
- **Goodness-of-Fit ($R^2$)**: $> 0.96$ consistently.
- **Zero clinical tier misclassification** across simulated normoperfusion ($1.2\text{s}$), compensated shock ($2.5\text{s}$), and decompensated shock ($3.4\text{s}$).
