HirthikBalaji/ShockGuard-CAD/Renders/_raw/measurement_zone.png

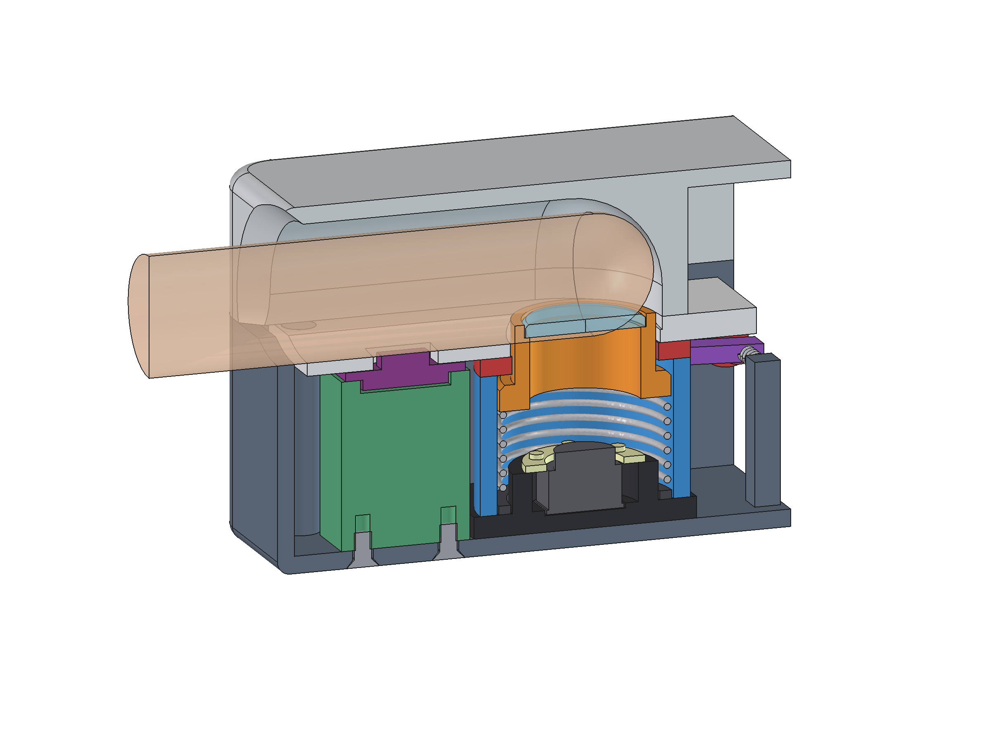
Renders/_raw/measurement_zone.png
