HirthikBalaji/ShockGuard-CAD/Drawings/ShockGuard_Engineering_Drawings.pdf

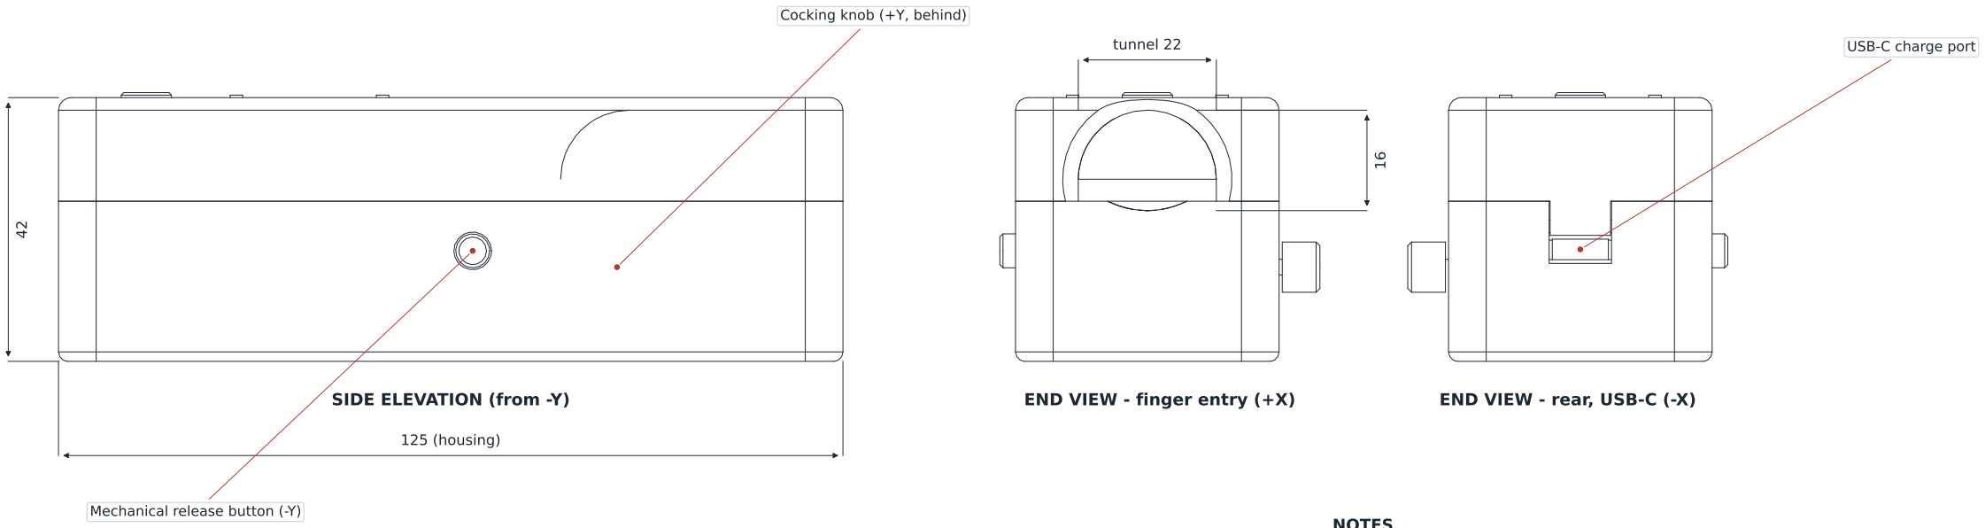
[picture p67: figure]
SIDE ELEVATION (from -Y); 125 (housing); tunnel 22; Cocking knob (+Y, behind); Mechanical release button (-Y); USB-C charge port

# ShockGuard - CRT / PPI fingertip triage device

# Assembly drawing - orthographic views, overall dimensions

## Scale 1:1 Units: mm Third-angle projection 2026-10-25

## Sheet 1 / 7 Rev A (concept)

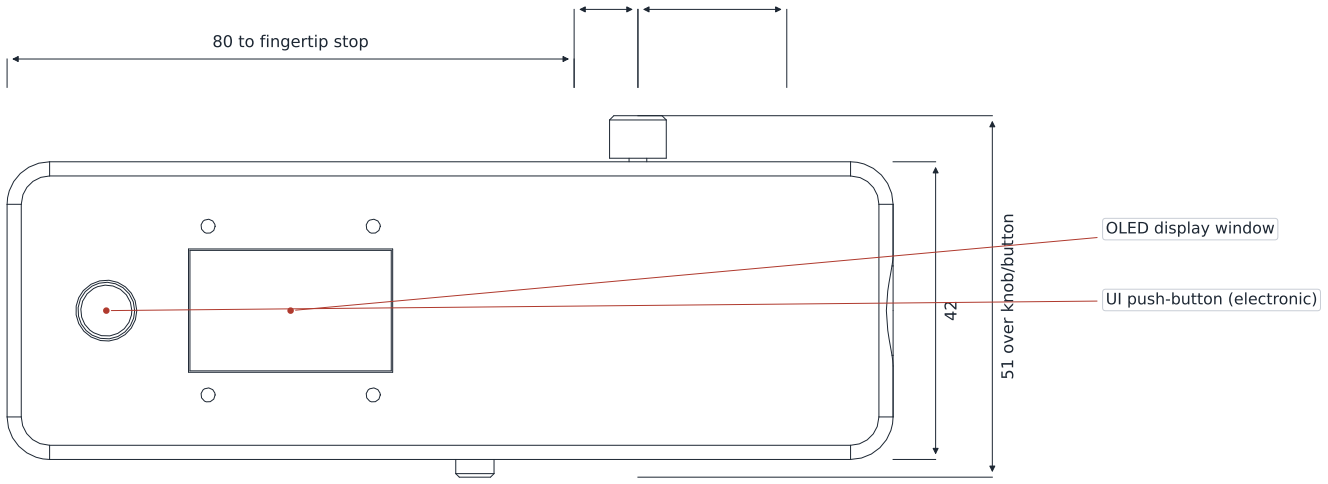
[picture p68: figure]
51 over knob/button; 80 to fingertip stop; OLED display window; UI push-button (electronic)
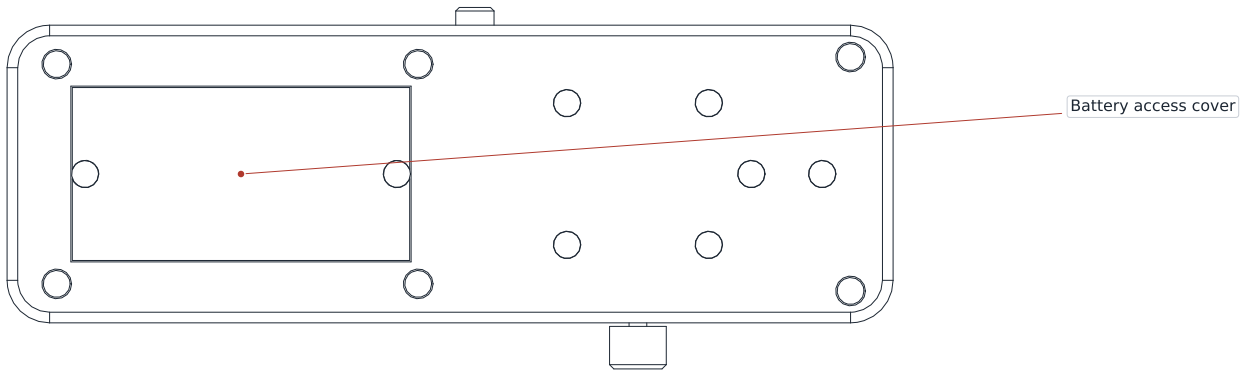
[picture p69: figure]
Battery access cover

PROPOSED ENGINEERING CONCEPT - NOT VALIDATED - NOT FOR CLINICAL USE | Source: ShockGuard_Assembly.FCStd

## PLAN (from +Z)

## UNDERSIDE (from -Z)

END VIEW - finger entry (+X) | END VIEW - rear, USB-C (-X)
9 | 21

## NOTES

1. Housing envelope 125 x 42 x 42 mm measured from CAD shells;

overall incl. knob / buttons 125 x 51 x 42.8 mm.

2. All dimensions are parametric (Params spreadsheet) and provisional.
3. Finger enters from +X, palm-side down; pulp rests in centring trough.
4. Split shell: lower = chassis/mechanism/electronics, upper = roof,

display, UI button, finger tunnel and reaction ceiling. 6x M2x30 from below.

5. Mechanical release (-Y) is separate from the electronic UI button (top).

## 6. Tolerances: none specified. FDM prototype; sliding fits set by

moving_part_clearance = 0.3 mm radial - tune by test print.

7. Materials are provisional assumptions; no part is validated for skin contact.
8. Force, contact pressure and dwell time NOT specified - load-cell calibration required.

Optical / plunger axis | PPG axis
OLED | ESP32-S3 carrier (placeholder) | Fingertip stop | Transparent contact window | Reaction ceiling | MAX30102 flush in trough

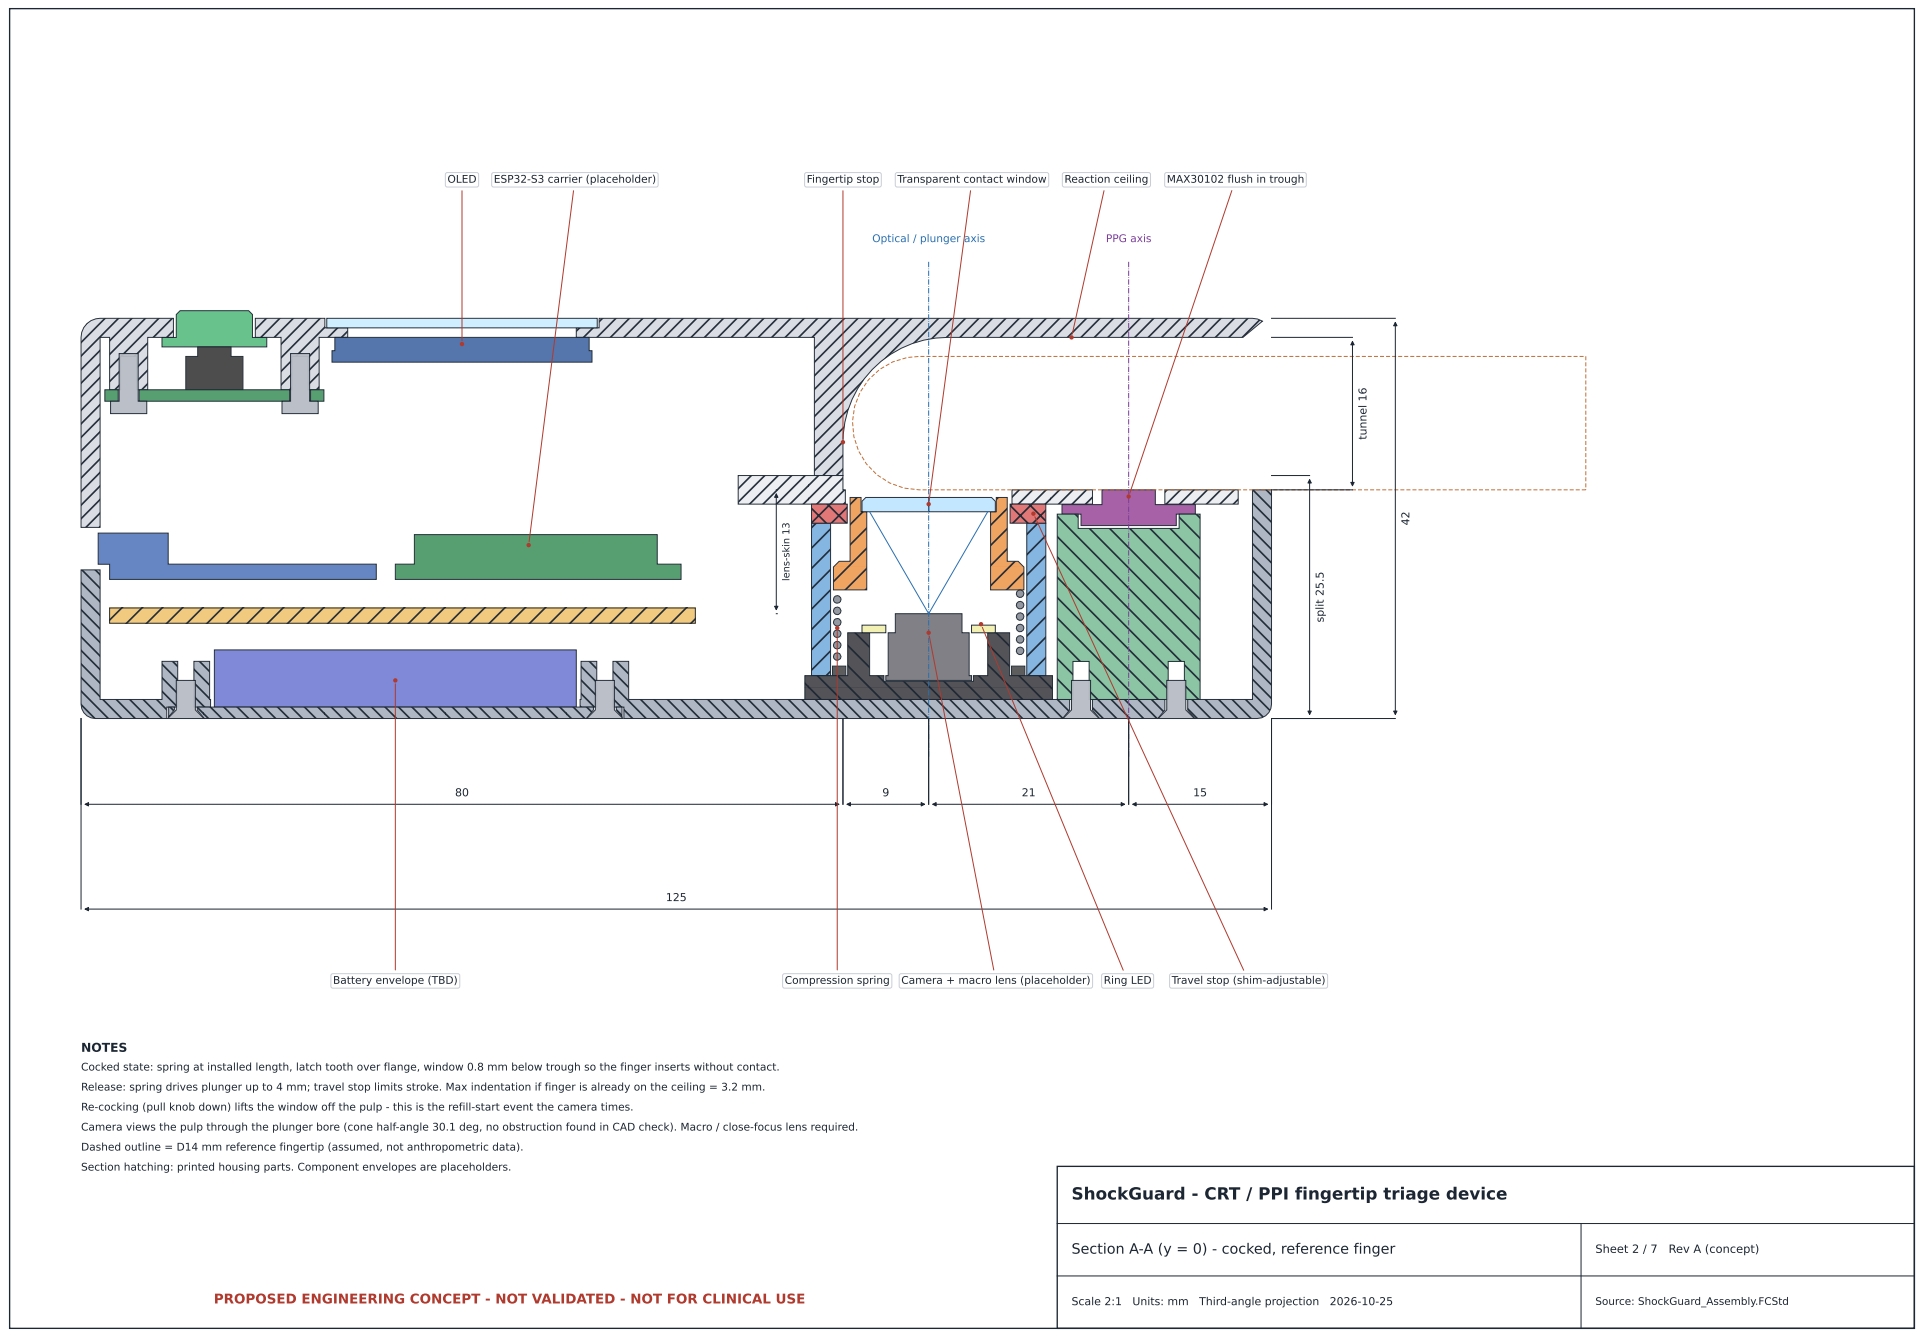
[picture p70: page 2]
split 25.5; tunnel 16; lens-skin 13; Battery envelope (TBD); Compression spring Camera + macro lens (placeholder); Ring LED; Travel stop (shim-adjustable); NOTES

Cocked state: spring at installed length, latch tooth over flange, window 0.8 mm below trough so the finger inserts without contact.

Release: spring drives plunger up to 4 mm; travel stop limits stroke. Max indentation if finger is already on the ceiling = 3.2 mm.

Re-cocking (pull knob down) lifts the window off the pulp - this is the refill-start event the camera times.

Camera views the pulp through the plunger bore (cone half-angle 30.1 deg, no obstruction found in CAD check). Macro / close-focus lens required.

Dashed outline = D14 mm reference fingertip (assumed, not anthropometric data).

Section hatching: printed housing parts. Component envelopes are placeholders.

ShockGuard - CRT / PPI fingertip triage device

Section A-A (y = 0) - cocked, reference finger

Sheet 2 / 7 Rev A (concept)

Scale 2:1 Units: mm Third-angle projection 2026-10-25

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

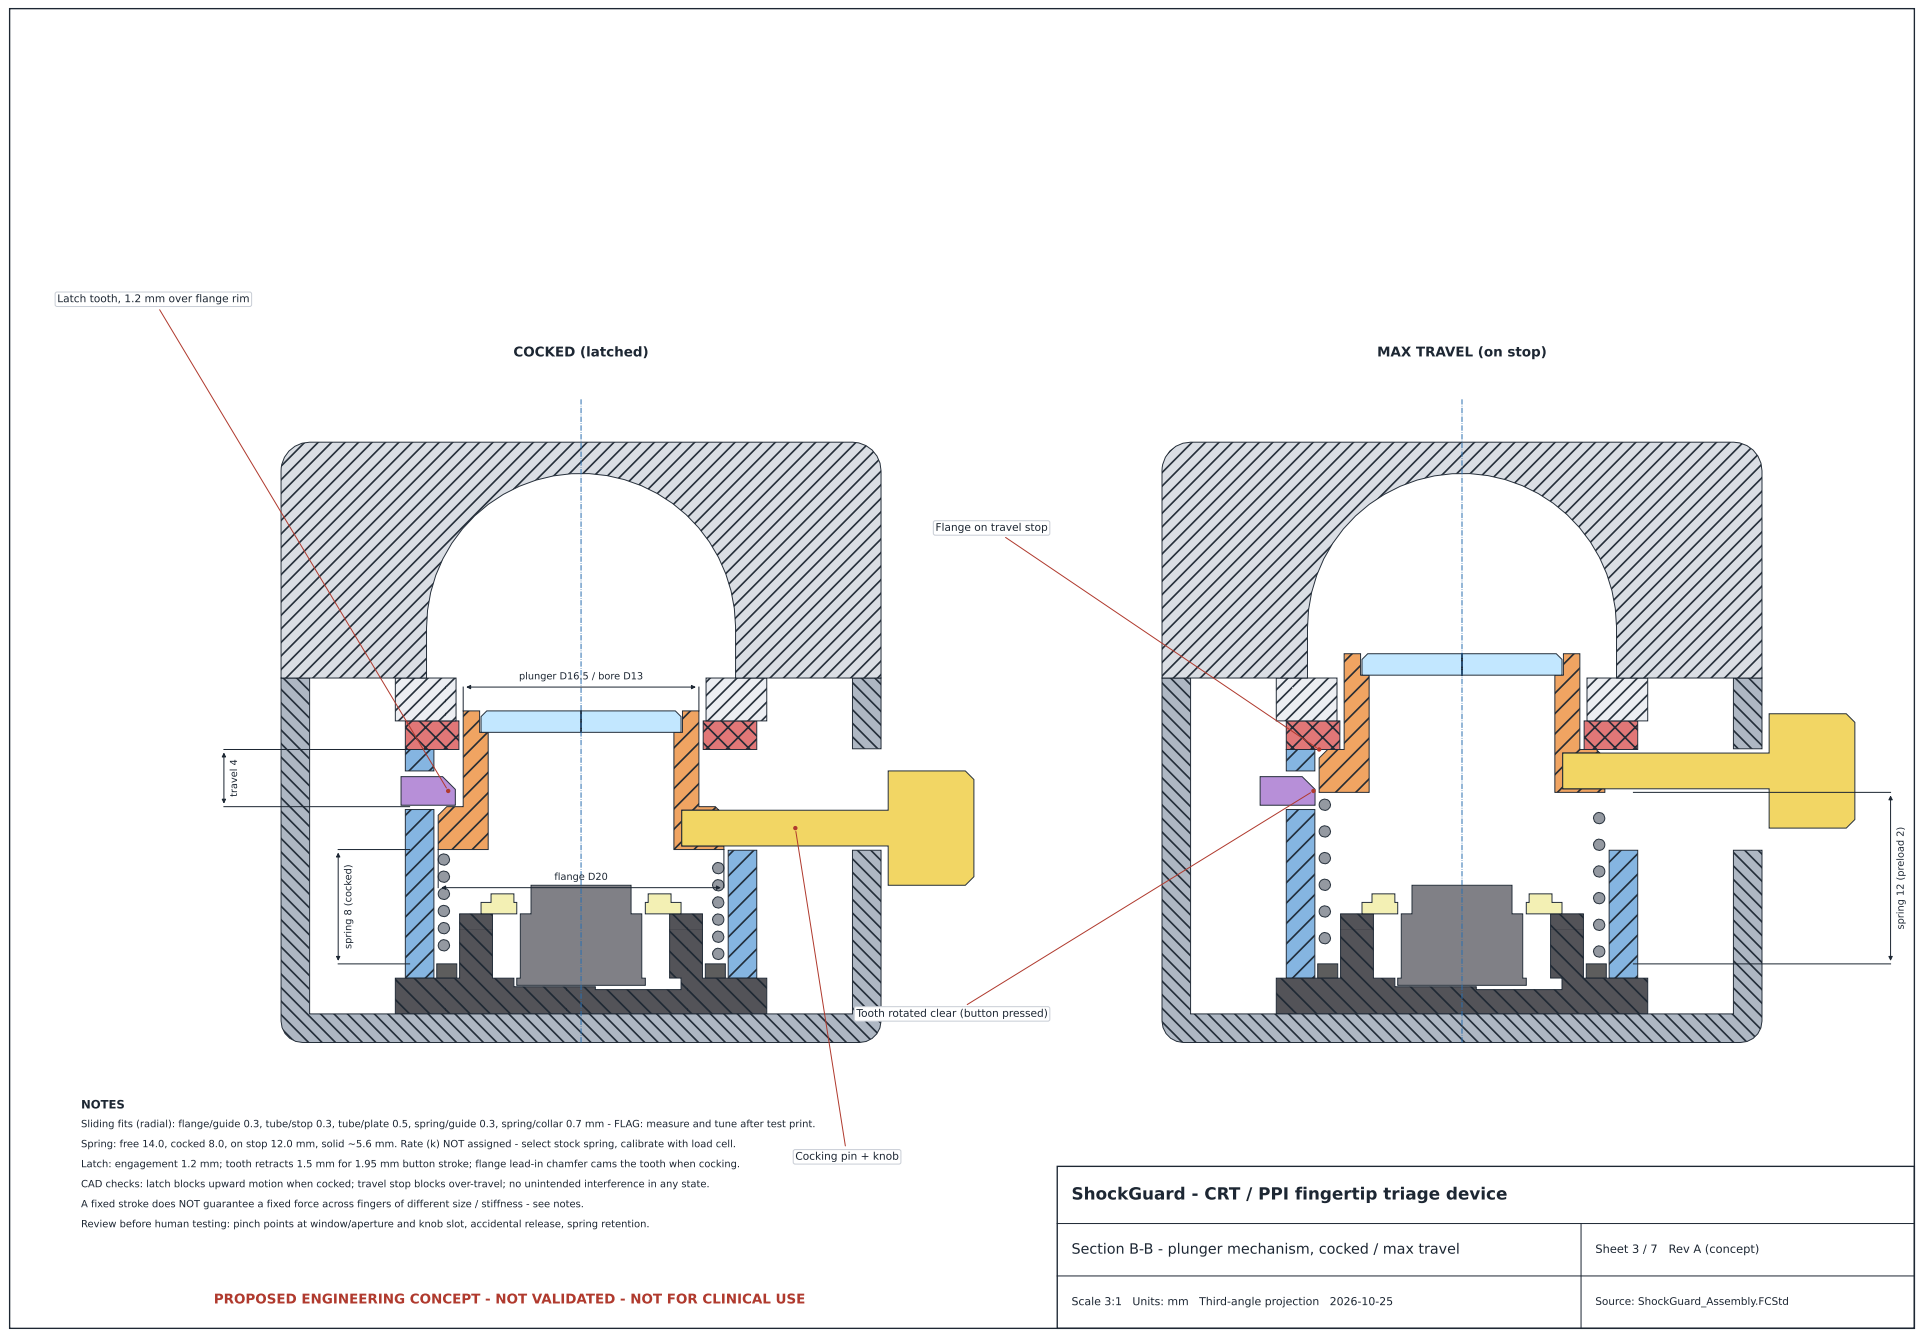
[picture p71: page 3]

OLED module (above, roof bosses) ESP32-S3-WROOM-1 on carrier (placeholder) Camera FPC route | Cocking knob | Finger-support plate | MAX30102

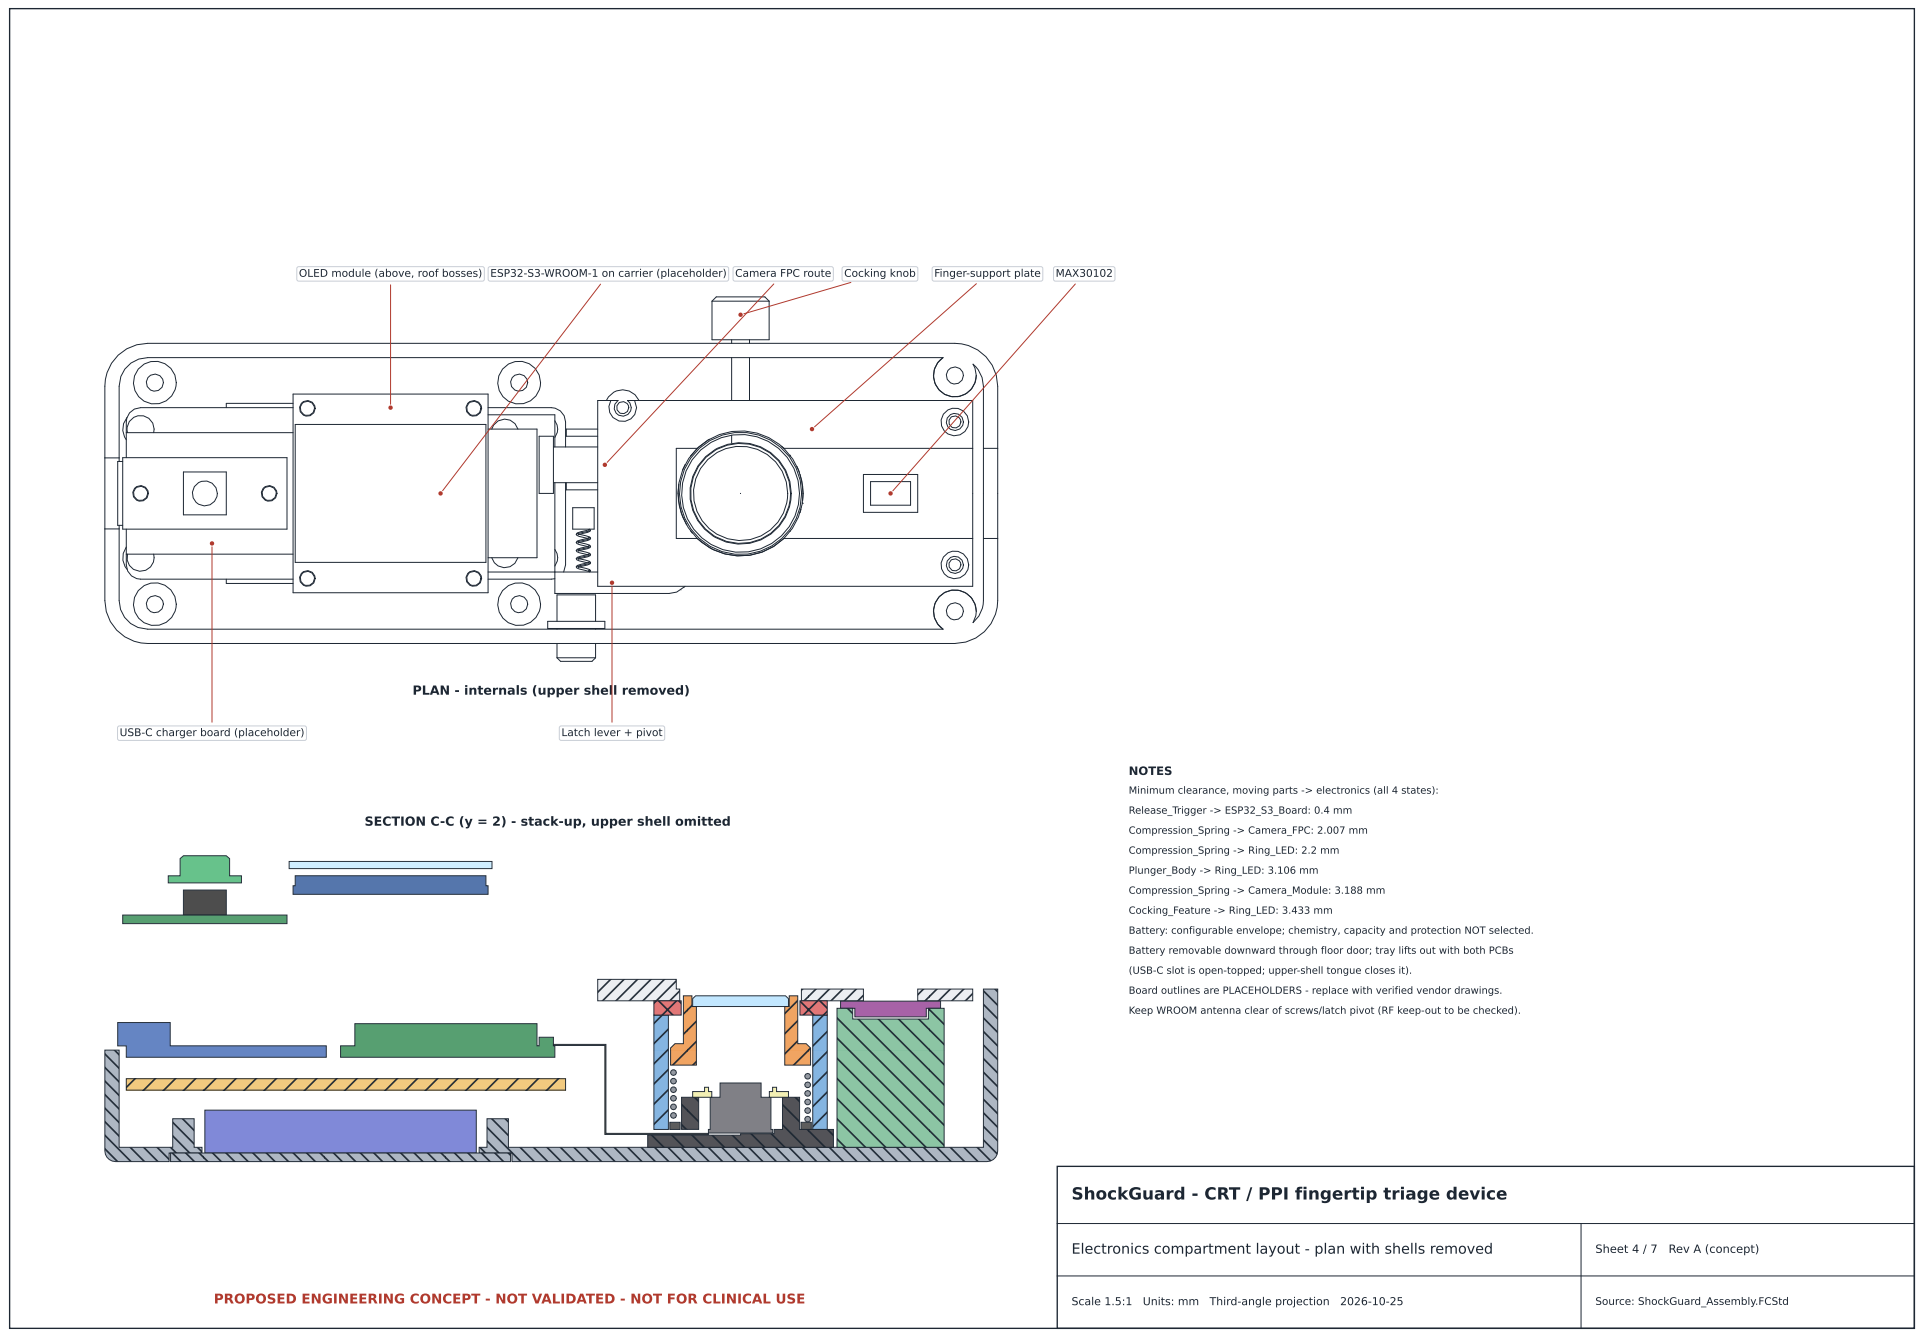
[picture p72: page 4]
USB-C charger board (placeholder); Latch lever + pivot; NOTES; Release_Trigger -> ESP32_S3_Board: 0.4 mm; Compression_Spring -> Camera_FPC: 2.007 mm; Compression_Spring -> Ring_LED: 2.2 mm; Plunger_Body -> Ring_LED: 3.106 mm; Compression_Spring -> Camera_Module: 3.188 mm; Cocking_Feature -> Ring_LED: 3.433 mm

PLAN - internals (upper shell removed)

Minimum clearance, moving parts -> electronics (all 4 states):

SECTION C-C (y = 2) - stack-up, upper shell omitted

Battery: configurable envelope; chemistry, capacity and protection NOT selected.

Battery removable downward through floor door; tray lifts out with both PCBs

(USB-C slot is open-topped; upper-shell tongue closes it).

Board outlines are PLACEHOLDERS - replace with verified vendor drawings.

Keep WROOM antenna clear of screws/latch pivot (RF keep-out to be checked).

ShockGuard - CRT / PPI fingertip triage device

Electronics compartment layout - plan with shells removed

Sheet 4 / 7 Rev A (concept)

Scale 1.5:1 Units: mm Third-angle projection 2026-10-25

stop -> camera axis 9 | camera -> PPG 21 16
Fingertip stop (repeatable X datum) | Window indents pulp (blanch zone, illustrative) | MAX30102 face flush with trough

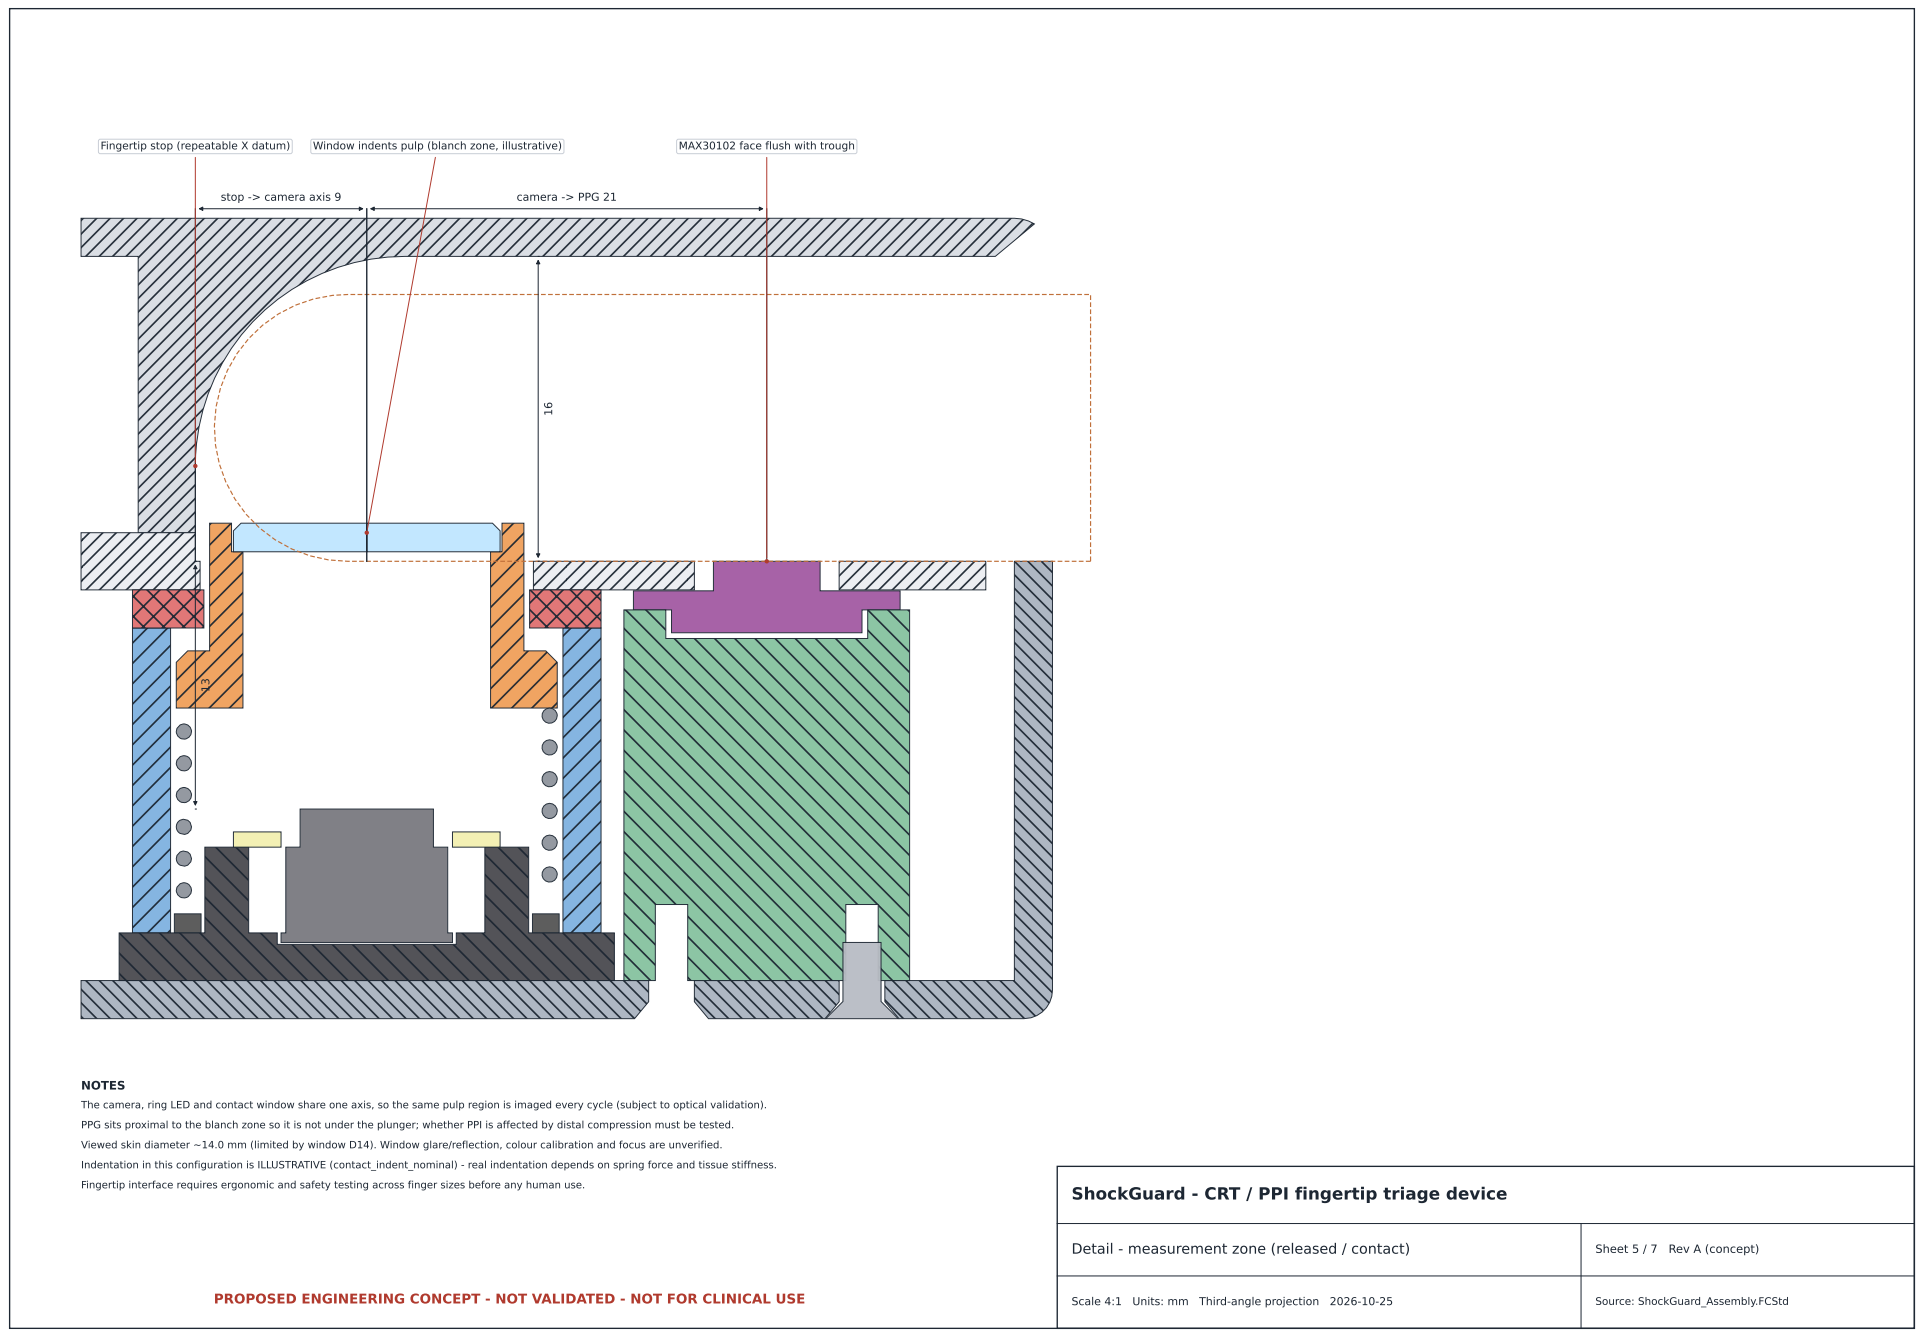
[picture p73: page 5]
NOTES

The camera, ring LED and contact window share one axis, so the same pulp region is imaged every cycle (subject to optical validation).

PPG sits proximal to the blanch zone so it is not under the plunger; whether PPI is affected by distal compression must be tested.

Viewed skin diameter ~14.0 mm (limited by window D14). Window glare/reflection, colour calibration and focus are unverified.

Indentation in this configuration is ILLUSTRATIVE (contact_indent_nominal) - real indentation depends on spring force and tissue stiffness.

Fingertip interface requires ergonomic and safety testing across finger sizes before any human use.

ShockGuard - CRT / PPI fingertip triage device

Detail - measurement zone (released / contact)

Sheet 5 / 7 Rev A (concept)

Scale 4:1 Units: mm Third-angle projection 2026-10-25

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

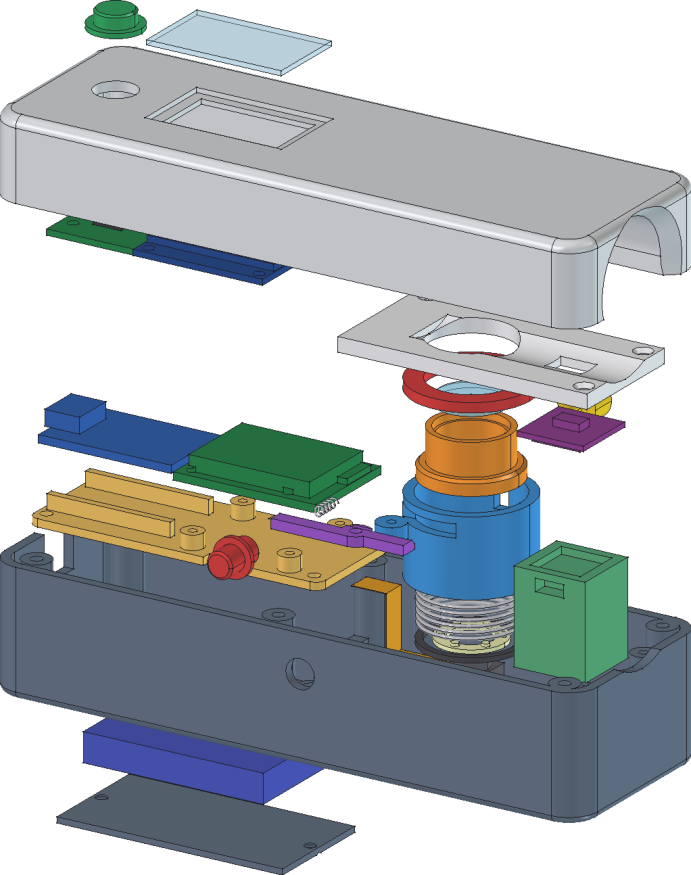
[picture p74: figure]

# ShockGuard - CRT / PPI fingertip triage device

Master parameters (Params spreadsheet) - status flags | Sheet 7 / 7 Rev A (concept)

## Scale - Units: mm Third-angle projection 2026-10-25

PARAMETER | VALUE | STATUS
overall_length | 125.0 | ASSUMED
overall_width | 42.0 | ASSUMED
overall_height | 42.0 | ASSUMED
corner_radius | 6.0 | ASSUMED
top_edge_fillet | 2.0 | ASSUMED
bottom_edge_fillet | 1.5 | ASSUMED
enclosure_wall_thickness | 2.0 | VERIFY
finger_opening_width | 22.0 | VERIFY
finger_opening_height | 16.0 | VERIFY
finger_support_length | 45.0 | ASSUMED
trough_radius | 14.0 | ASSUMED
trough_depth | 1.5 | ASSUMED
camera_mount_position | 9.0 | VERIFY
ppg_mount_position | 21.0 | VERIFY
plate_half_width | 13.0 | ASSUMED
plunger_diameter | 16.5 | ASSUMED
plunger_bore | 13.0 | ASSUMED
flange_diameter | 20.0 | ASSUMED
flange_thickness | 3.0 | ASSUMED
flange_chamfer | 0.6 | ASSUMED
plunger_travel | 4.0 | VERIFY
plunger_rest_gap | 0.8 | ASSUMED
contact_indent_nominal | 2.0 | VERIFY
contact_pad_diameter | 14.0 | ASSUMED
contact_pad_thickness | 1.5 | ASSUMED
spring_outer_diameter | 20.0 | PLACEHOLDER
spring_wire_diameter | 0.8 | PLACEHOLDER
spring_free_length | 14.0 | PLACEHOLDER
spring_installed_length | 8.0 | VERIFY
spring_total_coils | 6.0 | PLACEHOLDER
guide_wall | 2.0 | ASSUMED
spring_seat_thickness | 1.0 | ASSUMED
stop_thickness | 2.0 | VERIFY
support_plate_thickness | 3.0 | ASSUMED
moving_part_clearance | 0.3 | VERIFY
plunger_hole_clearance | 0.5 | ASSUMED
cocking_pin_diameter | 2.5 | ASSUMED
knob_diameter | 8.0 | ASSUMED
knob_length | 6.0 | ASSUMED
latch_overlap | 1.2 | VERIFY
latch_thickness | 2.0 | ASSUMED
latch_release_angle | 8.6 deg | DERIVED
release_button_x_offset | 23.0 | ASSUMED
optical_mount_thickness | 2.5 | ASSUMED
optical_mount_size | 26.0 | ASSUMED
collar_od | 17.0 | ASSUMED
collar_id | 12.4 | ASSUMED
cam_board_size | 9.0 | PLACEHOLDER
cam_board_t | 0.5 | PLACEHOLDER
PARAMETER | VALUE | STATUS
cam_holder | 8.5 | PLACEHOLDER
cam_holder_h | 4.5 | PLACEHOLDER
cam_barrel_d | 7.0 | PLACEHOLDER
cam_barrel_h | 2.0 | PLACEHOLDER
ring_light_diameter | 14.0 | PLACEHOLDER
ring_light_inner | 9.0 | PLACEHOLDER
ring_light_thickness | 0.8 | PLACEHOLDER
ring_led_radius | 5.5 | PLACEHOLDER
max_pcb | 14.0 | PLACEHOLDER
max_pcb_t | 1.0 | PLACEHOLDER
max_sensor_l | 5.6 | PLACEHOLDER
max_sensor_w | 3.3 | PLACEHOLDER
max_sensor_h | 1.55 | PLACEHOLDER
oled_pcb_w | 27.3 | PLACEHOLDER
oled_pcb_h | 27.8 | PLACEHOLDER
oled_pcb_t | 1.2 | PLACEHOLDER
oled_glass_w | 26.7 | PLACEHOLDER
oled_glass_h | 19.3 | PLACEHOLDER
oled_glass_t | 1.4 | PLACEHOLDER
oled_window_width | 24.0 | ASSUMED
oled_window_height | 13.0 | ASSUMED
oled_position_x | 40.0 | ASSUMED
oled_lens_t | 1.0 | ASSUMED
button_position_x | 14.0 | ASSUMED
button_cap_d | 8.0 | ASSUMED
esp_x0 | 33.0 | ASSUMED
esp_pcb_l | 30.0 | PLACEHOLDER
esp_pcb_w | 22.0 | PLACEHOLDER
pcb_t | 1.6 | ASSUMED
wroom_l | 25.5 | PLACEHOLDER
wroom_w | 18.0 | PLACEHOLDER
wroom_h | 3.1 | PLACEHOLDER
chg_pcb_l | 28.0 | PLACEHOLDER
chg_pcb_w | 17.0 | PLACEHOLDER
usbc_w | 8.94 | PLACEHOLDER
usbc_l | 7.35 | PLACEHOLDER
usbc_h | 3.26 | PLACEHOLDER
battery_length | 38.0 | PLACEHOLDER
battery_width | 22.0 | PLACEHOLDER
battery_thickness | 6.0 | PLACEHOLDER
battery_x_center | 33.0 | ASSUMED
tray_z | 10.0 | ASSUMED
tray_thickness | 1.6 | ASSUMED
standoff_h | 3.0 | ASSUMED
electronics_clearance | 1.0 | VERIFY
screw_d | 2.0 | ASSUMED
fastener_clearance | 0.2 | VERIFY
pilot_d | 1.7 | VERIFY
state | 2.0 | CONFIG
PARAMETER | VALUE | STATUS
explode | 0.0 | CONFIG
x_tip | 80.0 | DERIVED
x_m | 89.0 | DERIVED
x_ppg | 110.0 | DERIVED
z_mount_top | 4.5 | DERIVED
z_seat_top | 5.5 | DERIVED
z_flange_bot | 13.5 | DERIVED
z_flange_top | 16.5 | DERIVED
z_guide_top | 20.5 | DERIVED
z_stop_top | 22.5 | DERIVED
z_split | 25.5 | DERIVED
z_fs | 24.0 | DERIVED
z_win_top | 23.2 | DERIVED
z_ceiling | 40.0 | DERIVED
z_tunnel_axis | 29.0 | DERIVED
top_over_tunnel | 2.0 | DERIVED
z_lens_top | 11.0 | DERIVED
working_distance | 13.0 | DERIVED
z_pin | 15.0 | DERIVED
guide_id | 20.6 | DERIVED
guide_od | 24.6 | DERIVED
stop_bore | 17.1 | DERIVED
z_lever_bot | 16.6 | DERIVED
z_lever_top | 18.6 | DERIVED
z_lever_mid | 17.6 | DERIVED
latch_pivot_x | 79.0 | DERIVED
latch_pivot_y | -11.0 | DERIVED
latch_tooth_y | -8.8 | DERIVED
release_button_x | 66.0 | DERIVED
latch_spring_x | 67.0 | DERIVED
latch_post_y | -5.0 | DERIVED
stroke | 0.0 | DERIVED
latch_angle | 0.0 deg | DERIVED
spring_len_current | 8.0 | DERIVED
latch_spring_len | 6.0 | DERIVED
z_tray_top | 11.6 | DERIVED
z_pcb_bot | 14.6 | DERIVED
z_pcb_top | 16.2 | DERIVED
z_usb_mid | 17.83 | DERIVED
z_oled_pcb_top | 38.6 | DERIVED
z_max_pcb_top | 22.45 | DERIVED
plate_x0 | 69.0 | DERIVED
plate_x1 | 121.5 | DERIVED
z_button_cap_bot | 39.0 | DERIVED
z_switch_bot | 34.5 | DERIVED
hole_r | 1.2 | DERIVED
pilot_r | 0.85 | DERIVED
spring_preload_at_stop | 2.0 | DERIVED

VERIFY = must be confirmed by test/analysis; PLACEHOLDER = replace with selected component datasheet; ASSUMED = modelling assumption; DERIVED = spreadsheet formula; CONFIG = state switch.
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
