HirthikBalaji/ShockGuard-CAD/(commit log)

2026-10-25 Initialise repository: ignore rules and binary attributes for CAD assets
2026-10-25 Add master parameter table for the ShockGuard CAD model
    Inputs and derived formulas (valid in Python and as FreeCAD expressions),
    each tagged ASSUMED / VERIFY / PLACEHOLDER / DERIVED / CONFIG.
2026-10-25 Add parametric FreeCAD build script
    PartDesign bodies for enclosure, finger support, spring-plunger mechanism,
    optics, PPG, display, electronics and user controls; all dimensions bound
    to the Params spreadsheet; mechanism states and exploded view via
    placement expressions; fasteners as App::Links.
2026-10-25 Add CAD verification and export pipeline
    Integrity, 4-state interference, mechanism proofs, optical cone, service
    paths, FDM overhang, design rules, parameter-propagation test; STEP/STL
    export with re-import checks; parameter and BOM CSVs.
2026-10-25 Add engineering drawing generator and one-command pipeline
    HLR orthographic views and planar sections from the CAD solids, laid out
    on A3 sheets with model-measured dimensions.
2026-10-25 Add generated parametric assembly (ShockGuard_Assembly.FCStd)
    [ShockGuard_Assembly.FCStd]
2026-10-25 Add STEP assembly/components and STL exports (printable parts re-oriented)
    [Battery.step, Battery_Cover.step, Battery_Cover.stl, Button_PCB.step, Camera_FPC.step, Camera_Module.step, Charging_Board.step, Cocking_Feature.step]
2026-10-25 Add design notes, verification summary, regeneration guide, parameters, BOM
    [ShockGuard_BOM.csv, ShockGuard_Parameters.csv]
2026-10-25 Add KiCad schematic, 4-layer PCB layout, and BOM for ESP32-S3 carrier board
    [ShockGuard_Carrier.kicad_pcb, ShockGuard_Carrier.kicad_sch, ShockGuard_Electronics_BOM.csv]
2026-10-25 Add ESP32-S3 firmware: HAL, MAX30102 PPG driver, OV2640 camera, and SSD1306 UI
2026-10-25 Add electronics architecture, firmware guide, skin-tone calibration spec, and update README
2026-10-25 Add responsive interactive landing page and configure GitHub Pages
